RFisaac/PicoMondo/README.md

# PicoMondo

RP2350B control board for museum and maker exhibits (Clark Planetarium), designed in KiCad 10.

- `kicad/` is the project (`picomondo.kicad_pro`). Start with `kicad/README.md` and `kicad/DECISIONS.md`.
- `kicad/tools/` holds the Python scripts that generate and check the schematic and board.
