RFisaac/PicoMondo/kicad/bom/BOM_REPORT.md

# BOM report

Generated by `tools/bom.py` from `picomondo.kicad_pcb`. 240 parts with an LCSC number on 67 line items; 46 extended or preferred line items (JLCPCB charges a loading fee per extended part type; check their current fee schedule). Stock check assumes 5 boards and a 3x margin.

## Line items

| Refs | Qty | Value | LCSC | Type | Stock | Unit price | Note |
|---|---|---|---|---|---|---|---|
| C1,C2,C5... | 4 | 4.7u | C23733 | basic | 2365245 | 0.0167 |  |
| C3,C4,C7... | 20 | 100n | C307331 | basic | 15344796 | 0.0092 |  |
| C17,C18 | 2 | 15p | C106997 | extended | 2278248 | 0.0020 |  |
| C21,C22,C23... | 4 | 10u 50V | C7432782 | extended | 100526 | 0.2051 |  |
| C29,C30,C31... | 6 | 22u 16V | C2985039 | extended | 801 | 0.3191 |  |
| C37 | 1 | 10n | C15195 | basic | 4017940 | 0.0050 |  |
| C38 | 1 | 3.3n | C26404 | preferred | 232147 | 0.0068 |  |
| C16,C36,C40... | 7 | 10u 10V | C15850 | basic | 4904066 | 0.0657 |  |
| C46 | 1 | 4.7u 25V | C1779 | basic | 2968755 | 0.0348 |  |
| C47,C48 | 2 | 1u 10V | C52923 | basic | 8321740 | 0.0108 |  |
| C49 | 1 | 1u 25V | C5673 | extended | 4396637 | 0.0278 |  |
| D1,D2,D3 | 3 | SS54F-HF 5A 40V | C5142774 | extended | 5302 | 0.2241 |  |
| D4 | 1 | SMBJ28A | C178227 | extended | 26078 | 0.1079 |  |
| D6 | 1 | BZT52C12 12V | C177013 | extended | 6524 | 0.0570 |  |
| D5,D7 | 2 | SS54-HF | C22452 | basic | 2389672 | 0.0447 |  |
| D8 | 1 | red | C2286 | basic | 4789156 | 0.0076 |  |
| D9 | 1 | ESDA25P35-1U1M | C1974707 | extended | 1426 | 0.1904 |  |
| D10 | 1 | ESDA25W | C2935152 | extended | 1027 | 0.1444 |  |
| D11,D12,D13... | 32 | white | C7220928 | extended | 545 | 0.2657 |  |
| D41 | 1 | 1N5819HW | C82544 | extended | 138574 | 0.0570 |  |
| D42 | 1 | WS2812B-V5 | C2874885 | extended | 89621 | 0.1107 |  |
| F1 | 1 | 5A hold 30V | C19078763 | extended | 68759 | 0.1610 |  |
| F2,F3,F4 | 3 | 3A hold 33V | C54300298 | extended | 5652 | 0.2187 |  |
| J7,J8 | 2 | J8 V_INPUT out | C474881 | extended | 75284 | 0.1019 |  |
| J10 | 1 | SWD | C239521 | extended | 2288 | 0.2012 |  |
| J11 | 1 | Barrel 5.5x2.1 | C3096093 | extended | 1052 | 1.0956 |  |
| J12 | 1 | Terminal 2P | C2765055 | extended | 27443 |  |  |
| J13 | 1 | USB-C | C3020560 | extended | 591 | 1.3092 |  |
| J14,J16 | 2 | Arduino power | C124416 | extended | 2667 | 0.1777 |  |
| J15 | 1 | Arduino analog | C124415 | extended | 1403 | 0.1246 |  |
| J17 | 1 | Arduino digital 8-13 | C124423 | extended | 4711 | 0.1886 |  |
| J18,J19 | 2 | Pico right (pins 40-21) | C124410 | extended | 1093 | 0.3688 |  |
| L1 | 1 | 3.3u | C42411119 | extended | 1922 | 0.2858 |  |
| L2 | 1 | 4.7u | C19271849 | extended | 157 | 13.3080 |  |
| Q1,Q2 | 2 | CSD18543Q3A | C840100 | extended | 11977 | 0.8017 |  |
| Q4,Q6,Q8 | 3 | MMBT3904 | C81464 | extended | 1556997 | 0.0167 |  |
| Q5 | 1 | DMP4015SSS-13 | C508210 | extended | 2589 | 1.2977 |  |
| Q3,Q7 | 2 | SI2305A | C347488 | extended | 47845 | 0.0409 |  |
| R1 | 1 | 33 | C25105 | basic | 1815062 | 0.0012 |  |
| R10,R11 | 2 | 27 | C25100 | extended | 56281 | 0.0019 |  |
| R12 | 1 | 10m 1% 1W | C500718 | extended | 2320 | 0.0814 |  |
| R13 | 1 | 49.9k 1% | C25897 | preferred | 35168 | 0.0015 |  |
| R14 | 1 | 33.2k 1% | C122548 | extended | 349568 | 0.0007 |  |
| R3,R16 | 2 | 0 | C17168 | basic | 9185166 | 0.0025 |  |
| R17 | 1 | 7.5k | C25918 | preferred | 1196541 | 0.0022 |  |
| R18 | 1 | 220k 1% | C25767 | preferred | 158069 | 0.0023 |  |
| R19 | 1 | 88.7k 1% | C25922 | extended | 101022 | 0.0016 |  |
| R22,R28,R33 | 3 | 47k | C25792 | basic | 5520539 | 0.0026 |  |
| R15,R25,R31... | 6 | 100k | C25741 | basic | 8203089 | 0.0025 |  |
| R21,R27 | 2 | 20m 1% 2W | C500720 | extended | 3543 | 0.0800 |  |
| R29 | 1 | 22k | C31850 | basic | 3694042 | 0.0042 |  |
| R32 | 1 | 22k | C25768 | basic | 813018 | 0.0024 |  |
| R20,R23,R24... | 14 | 10k | C25744 | basic | 21560265 | 0.0034 |  |
| R2,R8,R9... | 5 | 1k | C11702 | basic | 7068307 | 0.0019 |  |
| R43,R111,R112 | 3 | 4.7k | C25900 | basic | 15447153 | 0.0027 |  |
| R44,R45,R46... | 29 | 100 | C25076 | basic | 4079878 | 0.0013 |  |
| R37,R72,R73... | 33 | 470 | C25117 | basic | 844142 | 0.0027 |  |
| SW1,SW2 | 2 | RESET | C318884 | basic | 467503 | 0.0207 |  |
| U1 | 1 | RP2350B | C42415655 | extended | 3393 | 1.2920 |  |
| U2 | 1 | W25Q128JVS | C97521 | basic | 48814 | 2.5782 |  |
| U4 | 1 | TPS55288 | C2864583 | extended | 5147 | 2.2214 |  |
| U5,U6 | 2 | AP2112K-3.3 | C51118 | extended | 37854 | 0.1726 |  |
| U7,U8 | 2 | INA226 (0x40) | C49851 | extended | 43725 | 0.7621 |  |
| U9 | 1 | USBLC6-2SC6 | C7519 | extended | 46944 | 0.1784 |  |
| U10 | 1 | STUSB4500 | C2678061 | extended | 4876 | 2.6826 |  |
| U11 | 1 | microSD | C428492 | extended | 23940 | 1.1476 |  |
| Y1 | 1 | ABM8-272-T3 | C20625731 | extended | 12836 | 0.6255 |  |

## Through-hole parts in the BOM (not in the SMD placement file)

D1, D2, D3, D5, D7, D10, D11, D12, D13, D14, D15, D16, D17, D18, D19, D20, D21, D22, D23, D24, D25, D26, D27, D28, D29, D30, D31, D32, D33, D34, D35, D36, D37, D38, D39, D40, D43, D44, F1, F2, F3, F4, J7, J8, J11, J14, J15, J16, J17, J18, J19

## Footprint-only items (no purchase)
