RFisaac/PicoMondo/kicad/picomondo.kicad_pcb

## KiCad design kicad/picomondo.kicad_pcb (2026-10-06)

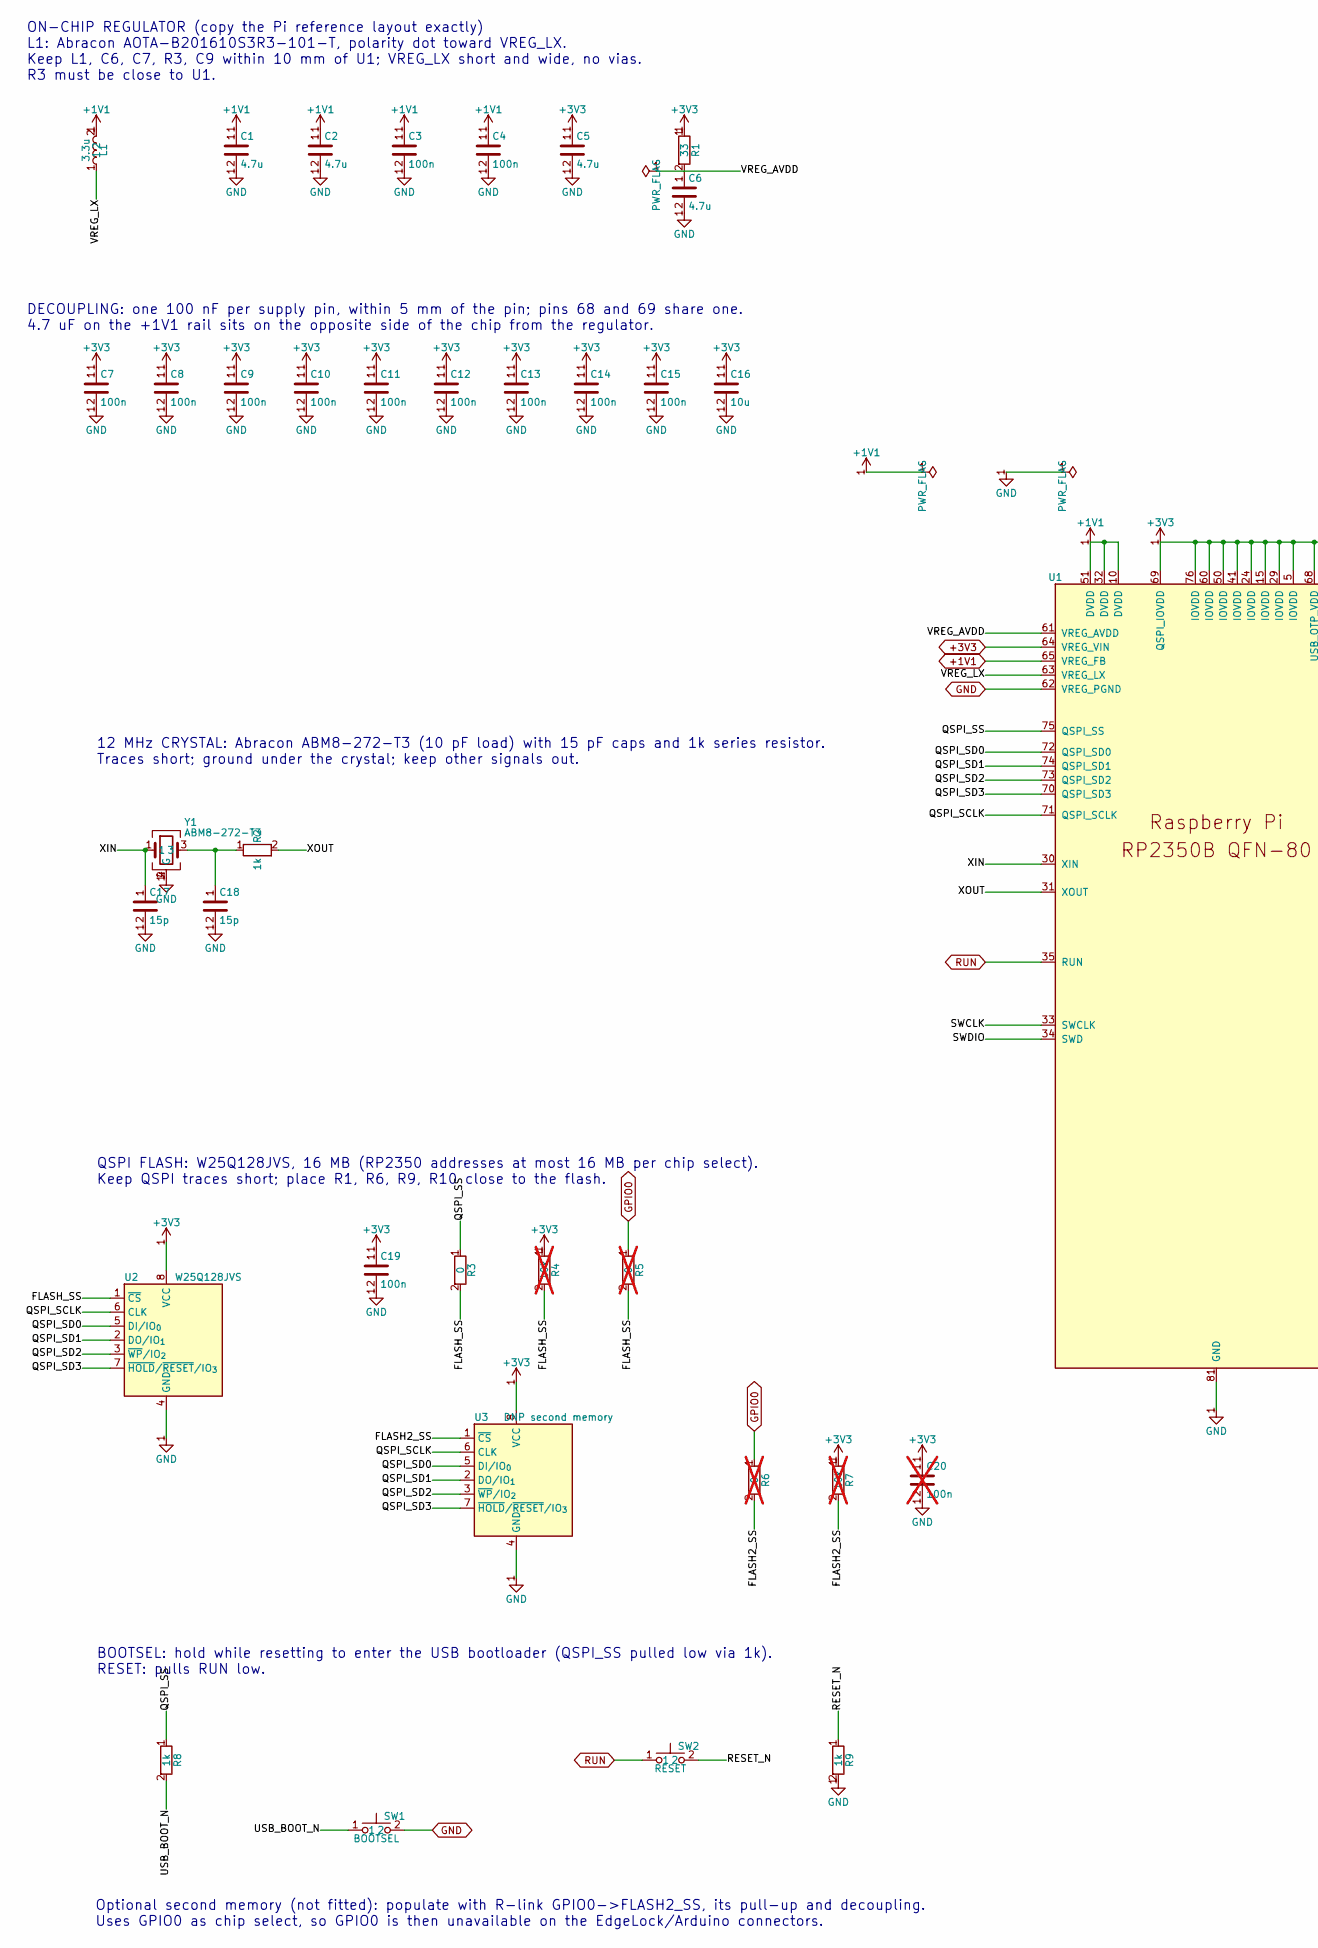
[picture p1: schematic mcu_core.kicad_sch, MCU core, part in row 1, column 1]

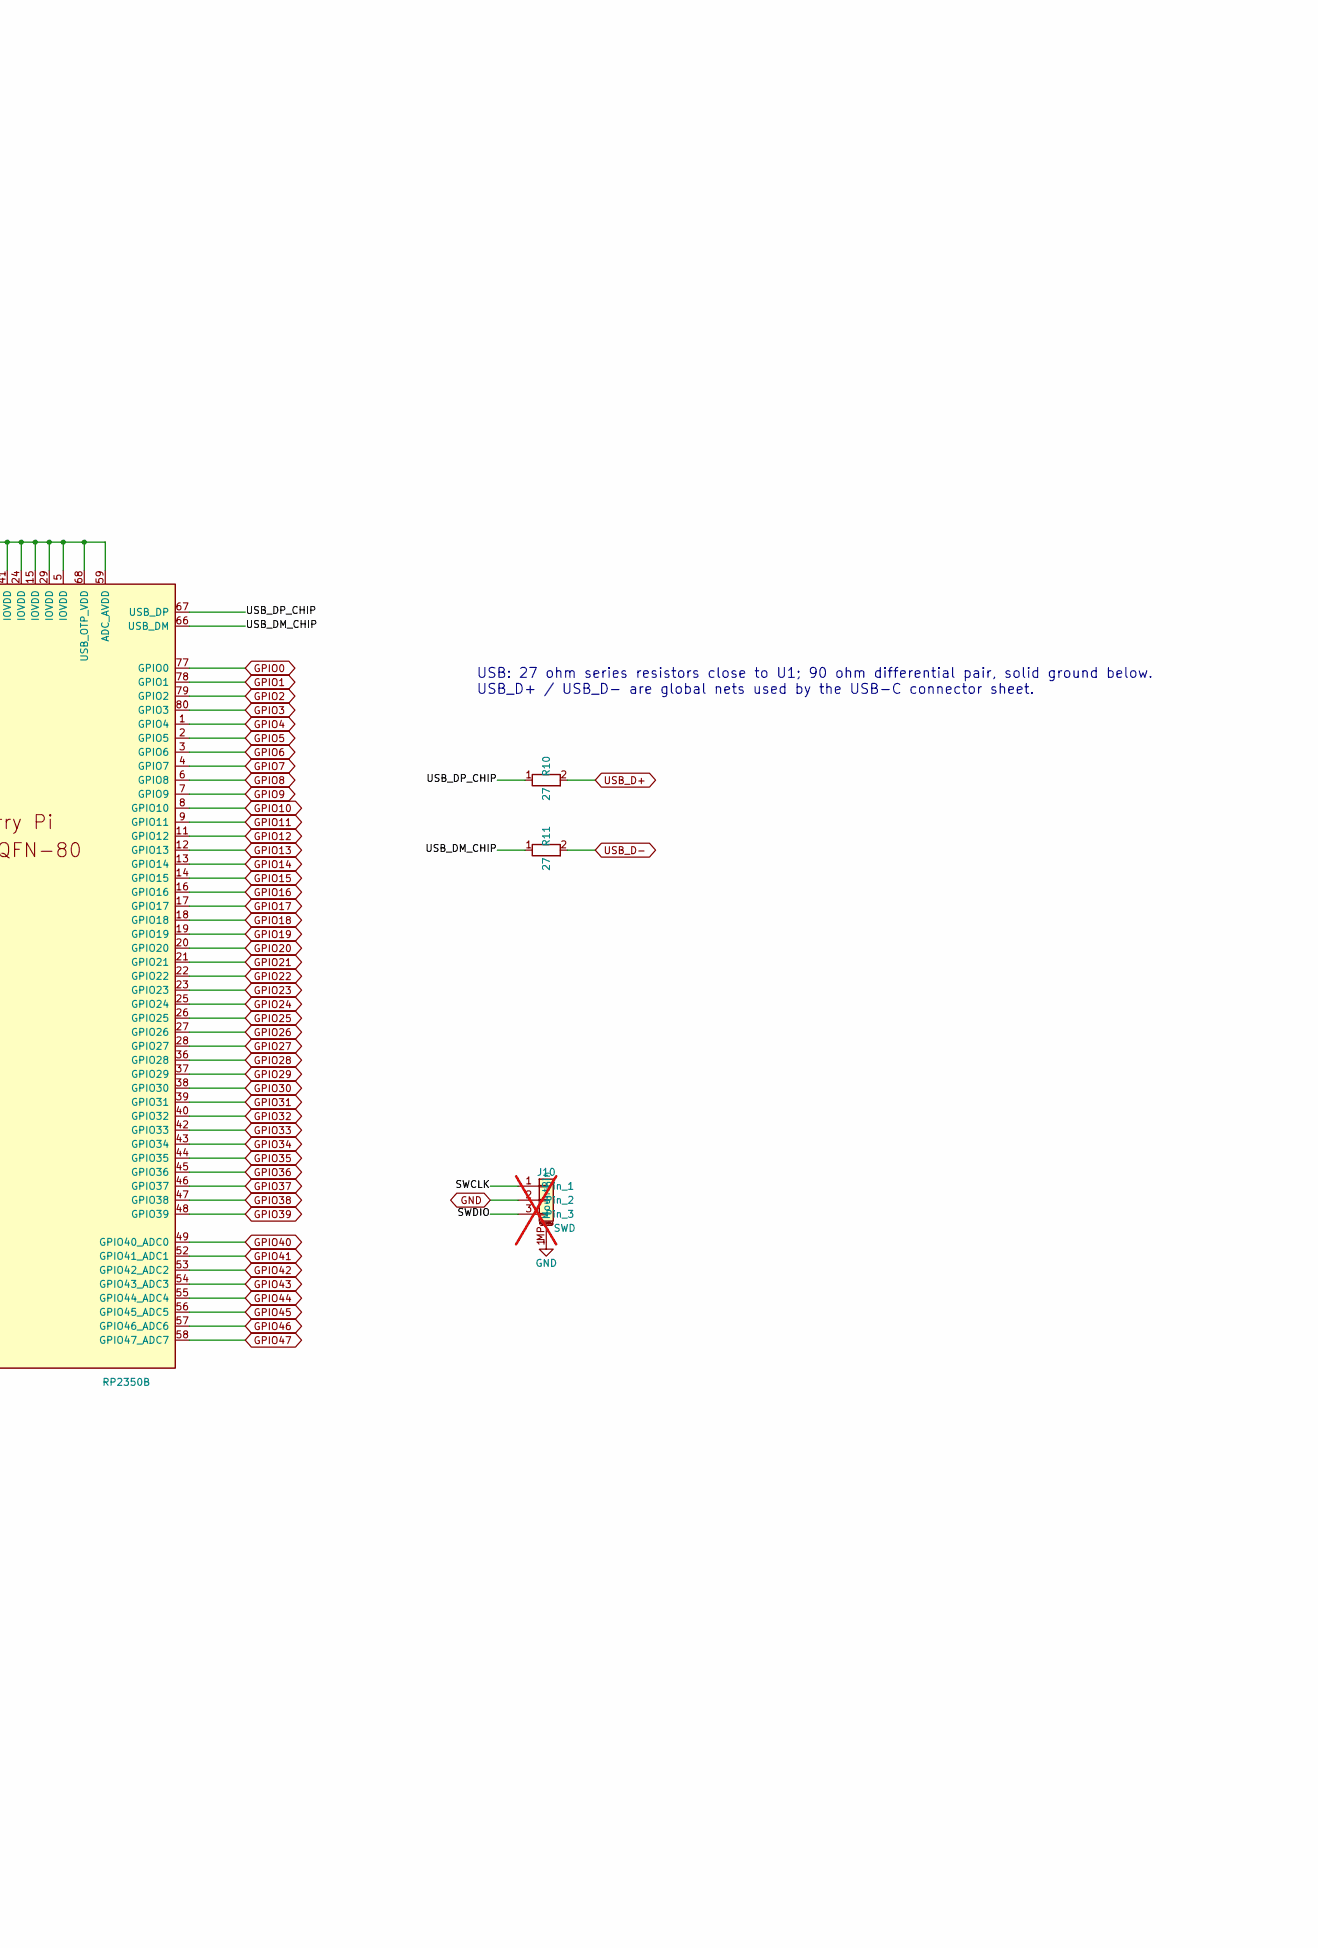
[picture p2: schematic mcu_core.kicad_sch, MCU core, part in row 1, column 2]

Parts:
C1, C2, C5, C6: 4.7u; C_0402_1005Metric_small_pads; MPN CL05A475MP5NRNC; LCSC C23733
C3, C4, C7, C8, C9, C10, C11, C12, C13, C14, C15, C19: 100n; C_0402_1005Metric; MPN CL05B104KB54PNC; LCSC C307331
C16: 10u; C_0805_2012Metric; MPN CL21A106KAYNNNE; LCSC C15850
C17, C18: 15p; C_0402_1005Metric; MPN CC0402JRNPO9BN150; LCSC C106997
C20: 100n; C_0402_1005Metric; MPN CL05B104KB54PNC; LCSC C307331; not fitted
J10: SWD; PinHeader_1x03_P2.54mm_Horizontal; LCSC C239521; not fitted
L1: 3.3u; L_pol_2016; MPN AOTA-B201610S3R3-101-T; LCSC C42411119
R1: 33; R_0402_1005Metric; MPN 0402WGF330JTCE; LCSC C25105
R2, R8, R9: 1k; R_0402_1005Metric; MPN 0402WGF1001TCE; LCSC C11702
R3: 0; R_0402_1005Metric; MPN 0402WGF0000TCE; LCSC C17168
R4, R7: 10k; R_0402_1005Metric; MPN 0402WGF1002TCE; LCSC C25744; not fitted
R5, R6: 0; R_0402_1005Metric; MPN 0402WGF0000TCE; LCSC C17168; not fitted
R10, R11: 27; R_0402_1005Metric; MPN 0402WGF270JTCE; LCSC C25100
SW1: BOOTSEL; SW_SMD_TS-1187A_5.1x5.1; MPN TS-1187A-B-A-B; LCSC C318884
SW2: RESET; SW_SMD_TS-1187A_5.1x5.1; MPN TS-1187A-B-A-B; LCSC C318884
U1: RP2350B; RP2350-QFN-80-1EP_10x10_P0.4mm_EP3.4x3.4mm_ThermalVias; MPN RP2350B; LCSC C42415655
U2: W25Q128JVS; SOIC-8_5.3x5.3mm_P1.27mm; MPN W25Q128JVSIQ; LCSC C97521
U3: DNP second memory; SOIC-8_5.3x5.3mm_P1.27mm
Y1: ABM8-272-T3; Crystal_SMD_3225-4Pin_3.2x2.5mm; MPN ABM8-272-T3; LCSC C20625731

Connections:
+1V1: C1.1, C2.1, C3.1, C4.1, L1.2, U1.10 (DVDD), U1.32 (DVDD), U1.51 (DVDD), U1.65 (VREG_FB); also elsewhere on the board
+3V3: C5.1, C7.1, C8.1, C9.1, C10.1, C11.1, C12.1, C13.1, C14.1, C15.1, C16.1, C19.1, C20.1, R1.1, R4.1, R7.1, U1.5 (IOVDD), U1.15 (IOVDD), U1.24 (IOVDD), U1.29 (IOVDD), U1.41 (IOVDD), U1.50 (IOVDD), U1.59 (ADC_AVDD), U1.60 (IOVDD), U1.64 (VREG_VIN), U1.68 (USB_OTP_VDD), U1.69 (QSPI_IOVDD), U1.76 (IOVDD), U2.8 (VCC), U3.8 (VCC); also elsewhere on the board
/MCU core/FLASH2_SS: R6.2, R7.2, U3.1 (~CS)
/MCU core/FLASH_SS: R3.2, R4.2, R5.2, U2.1 (~CS)
/MCU core/QSPI_SCLK: U1.71 (QSPI_SCLK), U2.6 (CLK), U3.6 (CLK)
/MCU core/QSPI_SD0: U1.72 (QSPI_SD0), U2.5 (DI/IO_{0}), U3.5 (DI/IO_{0})
/MCU core/QSPI_SD1: U1.74 (QSPI_SD1), U2.2 (DO/IO_{1}), U3.2 (DO/IO_{1})
/MCU core/QSPI_SD2: U1.73 (QSPI_SD2), U2.3 (~WP/IO_{2}), U3.3 (~WP/IO_{2})
/MCU core/QSPI_SD3: U1.70 (QSPI_SD3), U2.7 (~HOLD/~RESET/IO_{3}), U3.7 (~HOLD/~RESET/IO_{3})
/MCU core/QSPI_SS: R3.1, R8.1, U1.75 (QSPI_SS)
/MCU core/RESET_N: R9.1, SW2.2
/MCU core/SWCLK: J10.1, U1.33 (SWCLK)
/MCU core/SWDIO: J10.3, U1.34 (SWD)
/MCU core/USB_BOOT_N: R8.2, SW1.1
/MCU core/USB_DM_CHIP: R11.1, U1.66 (USB_DM)
/MCU core/USB_DP_CHIP: R10.1, U1.67 (USB_DP)
/MCU core/VREG_AVDD: C6.1, R1.2, U1.61 (VREG_AVDD)
/MCU core/VREG_LX: L1.1, U1.63 (VREG_LX)
/MCU core/XIN: C17.1, U1.30 (XIN), Y1.1
/MCU core/XOUT: R2.2, U1.31 (XOUT)
GND: C1.2, C2.2, C3.2, C4.2, C5.2, C6.2, C7.2, C8.2, C9.2, C10.2, C11.2, C12.2, C13.2, C14.2, C15.2, C16.2, C17.2, C18.2, C19.2, C20.2, J10.2, J10.MP (MountPin), R9.2, SW1.2, U1.62 (VREG_PGND), U1.81 (GND), U2.4 (GND), U3.4 (GND), Y1.2 (G), Y1.4 (G); also elsewhere on the board
GPIO0: R5.1, R6.1, U1.77 (GPIO0); also elsewhere on the board
GPIO1: U1.78 (GPIO1); also elsewhere on the board
GPIO2: U1.79 (GPIO2); also elsewhere on the board
GPIO3: U1.80 (GPIO3); also elsewhere on the board
GPIO4: U1.1 (GPIO4); also elsewhere on the board
GPIO5: U1.2 (GPIO5); also elsewhere on the board
GPIO6: U1.3 (GPIO6); also elsewhere on the board
GPIO7: U1.4 (GPIO7); also elsewhere on the board
GPIO8: U1.6 (GPIO8); also elsewhere on the board
GPIO9: U1.7 (GPIO9); also elsewhere on the board
GPIO10: U1.8 (GPIO10); also elsewhere on the board
GPIO11: U1.9 (GPIO11); also elsewhere on the board
GPIO12: U1.11 (GPIO12); also elsewhere on the board
GPIO13: U1.12 (GPIO13); also elsewhere on the board
GPIO14: U1.13 (GPIO14); also elsewhere on the board
GPIO15: U1.14 (GPIO15); also elsewhere on the board
GPIO16: U1.16 (GPIO16); also elsewhere on the board
GPIO17: U1.17 (GPIO17); also elsewhere on the board
GPIO18: U1.18 (GPIO18); also elsewhere on the board
GPIO19: U1.19 (GPIO19); also elsewhere on the board
GPIO20: U1.20 (GPIO20); also elsewhere on the board
GPIO21: U1.21 (GPIO21); also elsewhere on the board
GPIO22: U1.22 (GPIO22); also elsewhere on the board
GPIO23: U1.23 (GPIO23); also elsewhere on the board
GPIO24: U1.25 (GPIO24); also elsewhere on the board
GPIO25: U1.26 (GPIO25); also elsewhere on the board
GPIO26: U1.27 (GPIO26); also elsewhere on the board
GPIO27: U1.28 (GPIO27); also elsewhere on the board
GPIO28: U1.36 (GPIO28); also elsewhere on the board
GPIO29: U1.37 (GPIO29); also elsewhere on the board
GPIO30: U1.38 (GPIO30); also elsewhere on the board
GPIO31: U1.39 (GPIO31); also elsewhere on the board
GPIO32: U1.40 (GPIO32); also elsewhere on the board
GPIO33: U1.42 (GPIO33); also elsewhere on the board
GPIO34: U1.43 (GPIO34); also elsewhere on the board
GPIO35: U1.44 (GPIO35); also elsewhere on the board
GPIO36: U1.45 (GPIO36); also elsewhere on the board
GPIO37: U1.46 (GPIO37); also elsewhere on the board
GPIO38: U1.47 (GPIO38); also elsewhere on the board
GPIO39: U1.48 (GPIO39); also elsewhere on the board
GPIO40: U1.49 (GPIO40_ADC0); also elsewhere on the board
GPIO41: U1.52 (GPIO41_ADC1); also elsewhere on the board
GPIO42: U1.53 (GPIO42_ADC2); also elsewhere on the board
GPIO43: U1.54 (GPIO43_ADC3); also elsewhere on the board
GPIO44: U1.55 (GPIO44_ADC4); also elsewhere on the board
GPIO45: U1.56 (GPIO45_ADC5); also elsewhere on the board
GPIO46: U1.57 (GPIO46_ADC6); also elsewhere on the board
GPIO47: U1.58 (GPIO47_ADC7); also elsewhere on the board
unnamed: C18.1, R2.1, Y1.3
RUN: SW2.1, U1.35 (RUN); also elsewhere on the board
USB_D+: R10.2; also elsewhere on the board
USB_D-: R11.2; also elsewhere on the board

Notes on the sheet:
BOOTSEL: hold while resetting to enter the USB bootloader (QSPI_SS pulled low via 1k). RESET: pulls RUN low.
12 MHz CRYSTAL: Abracon ABM8-272-T3 (10 pF load) with 15 pF caps and 1k series resistor. Traces short; ground under the crystal; keep other signals out.
ON-CHIP REGULATOR (copy the Pi reference layout exactly) L1: Abracon AOTA-B201610S3R3-101-T, polarity dot toward VREG_LX. Keep L1, C6, C7, R3, C9 within 10 mm of U1; VREG_LX short and wide, no vias. R3 must be close to U1.
Optional second memory (not fitted): populate with R-link GPIO0->FLASH2_SS, its pull-up and decoupling. Uses GPIO0 as chip select, so GPIO0 is then unavailable on the EdgeLock/Arduino connectors.
QSPI FLASH: W25Q128JVS, 16 MB (RP2350 addresses at most 16 MB per chip select). Keep QSPI traces short; place R1, R6, R9, R10 close to the flash.
DECOUPLING: one 100 nF per supply pin, within 5 mm of the pin; pins 68 and 69 share one. 4.7 uF on the +1V1 rail sits on the opposite side of the chip from the regulator.
USB: 27 ohm series resistors close to U1; 90 ohm differential pair, solid ground below. USB_D+ / USB_D- are global nets used by the USB-C connector sheet.

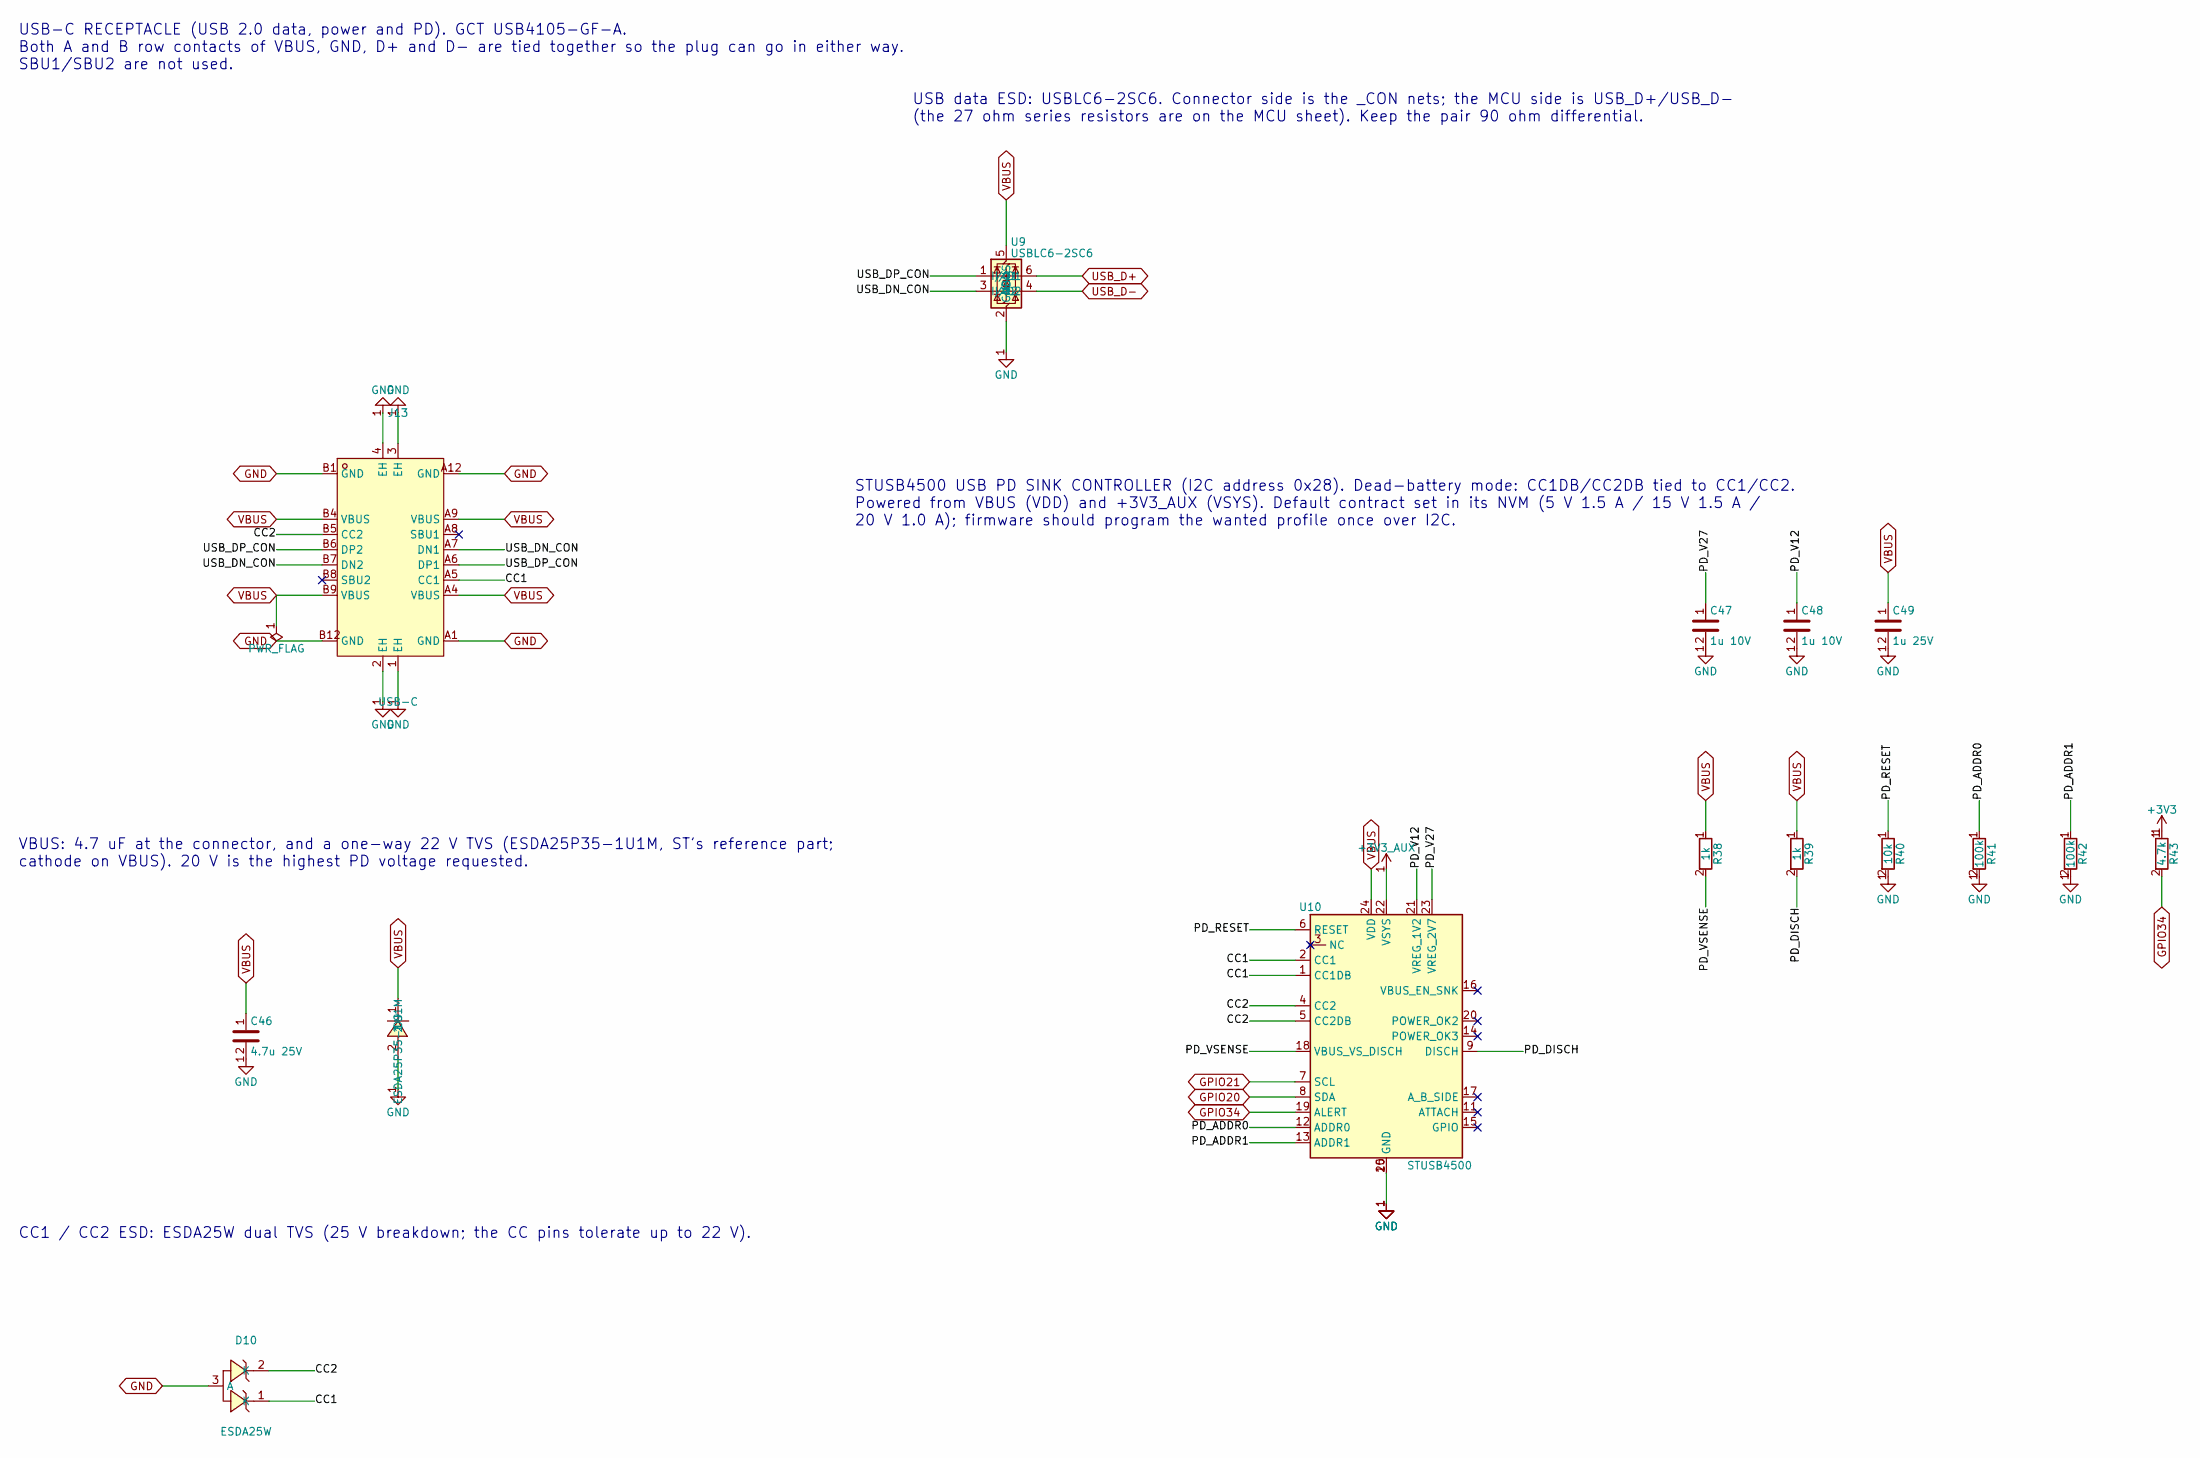
[picture p3: schematic usb_pd.kicad_sch, USB-C PD]

Parts:
C46: 4.7u 25V; C_0805_2012Metric; MPN CL21A475KAQNNNE; LCSC C1779
C47, C48: 1u 10V; C_0402_1005Metric; MPN CL05A105KA5NQNC; LCSC C52923
C49: 1u 25V; C_0603_1608Metric; MPN CL10A105KA8NNNC; LCSC C5673
D9: ESDA25P35-1U1M; DFN1610-2_L1.6-W1.0-P1.05-RD; MPN ESDA25P35-1U1M; LCSC C1974707
D10: ESDA25W; SOT-323-3_L2.1-W1.3-P1.32-LS2.1-BR; MPN ESDA25W; LCSC C2935152
J13: USB-C; TYPE-C-SMD_SBC-160S1A-20-S412; MPN USB4105-GF-A; LCSC C3020560
R38, R39: 1k; R_0402_1005Metric; MPN 0402WGF1001TCE; LCSC C11702
R40: 10k; R_0402_1005Metric; MPN 0402WGF1002TCE; LCSC C25744
R41, R42: 100k; R_0402_1005Metric; MPN 0402WGF1003TCE; LCSC C25741
R43: 4.7k; R_0402_1005Metric; MPN 0402WGF4701TCE; LCSC C25900
U9: USBLC6-2SC6; SOT-23-6; MPN USBLC6-2SC6; LCSC C7519
U10: STUSB4500; QFN-24-1EP_4x4mm_P0.5mm_EP2.7x2.7mm; MPN STUSB4500QTR; LCSC C2678061

Connections:
+3V3: R43.1; also elsewhere on the board
+3V3_AUX: U10.22 (VSYS); also elsewhere on the board
/USB-C PD/CC1: D10.1 (K), J13.A5 (CC1), U10.1 (CC1DB), U10.2 (CC1)
/USB-C PD/CC2: D10.2 (K), J13.B5 (CC2), U10.4 (CC2), U10.5 (CC2DB)
/USB-C PD/PD_ADDR0: R41.1, U10.12 (ADDR0)
/USB-C PD/PD_ADDR1: R42.1, U10.13 (ADDR1)
/USB-C PD/PD_DISCH: R39.2, U10.9 (DISCH)
/USB-C PD/PD_RESET: R40.1, U10.6 (RESET)
/USB-C PD/PD_V12: C48.1, U10.21 (VREG_1V2)
/USB-C PD/PD_V27: C47.1, U10.23 (VREG_2V7)
/USB-C PD/PD_VSENSE: R38.2, U10.18 (VBUS_VS_DISCH)
/USB-C PD/USB_DN_CON: J13.A7 (DN1), J13.B7 (DN2), U9.3 (I/O2)
/USB-C PD/USB_DP_CON: J13.A6 (DP1), J13.B6 (DP2), U9.1 (I/O1)
GND: C46.2, C47.2, C48.2, C49.2, D9.2, D10.3 (A), J13.1 (EH), J13.2 (EH), J13.3 (EH), J13.4 (EH), J13.A1 (GND), J13.A12 (GND), J13.B1 (GND), J13.B12 (GND), R40.2, R41.2, R42.2, U9.2 (GND), U10.10 (GND), U10.25 (GND); also elsewhere on the board
GPIO20: U10.8 (SDA); also elsewhere on the board
GPIO21: U10.7 (SCL); also elsewhere on the board
GPIO34: R43.2, U10.19 (ALERT); also elsewhere on the board
USB_D+: U9.6 (I/O1); also elsewhere on the board
USB_D-: U9.4 (I/O2); also elsewhere on the board
VBUS: C46.1, C49.1, D9.1, J13.A4 (VBUS), J13.A9 (VBUS), J13.B4 (VBUS), J13.B9 (VBUS), R38.1, R39.1, U9.5 (VBUS), U10.24 (VDD); also elsewhere on the board

Notes on the sheet:
VBUS: 4.7 uF at the connector, and a one-way 22 V TVS (ESDA25P35-1U1M, ST's reference part; cathode on VBUS). 20 V is the highest PD voltage requested.
USB data ESD: USBLC6-2SC6. Connector side is the _CON nets; the MCU side is USB_D+/USB_D- (the 27 ohm series resistors are on the MCU sheet). Keep the pair 90 ohm differential.
CC1 / CC2 ESD: ESDA25W dual TVS (25 V breakdown; the CC pins tolerate up to 22 V).
USB-C RECEPTACLE (USB 2.0 data, power and PD). GCT USB4105-GF-A. Both A and B row contacts of VBUS, GND, D+ and D- are tied together so the plug can go in either way. SBU1/SBU2 are not used.
STUSB4500 USB PD SINK CONTROLLER (I2C address 0x28). Dead-battery mode: CC1DB/CC2DB tied to CC1/CC2. Powered from VBUS (VDD) and +3V3_AUX (VSYS). Default contract set in its NVM (5 V 1.5 A / 15 V 1.5 A / 20 V 1.0 A); firmware should program the wanted profile once over I2C.

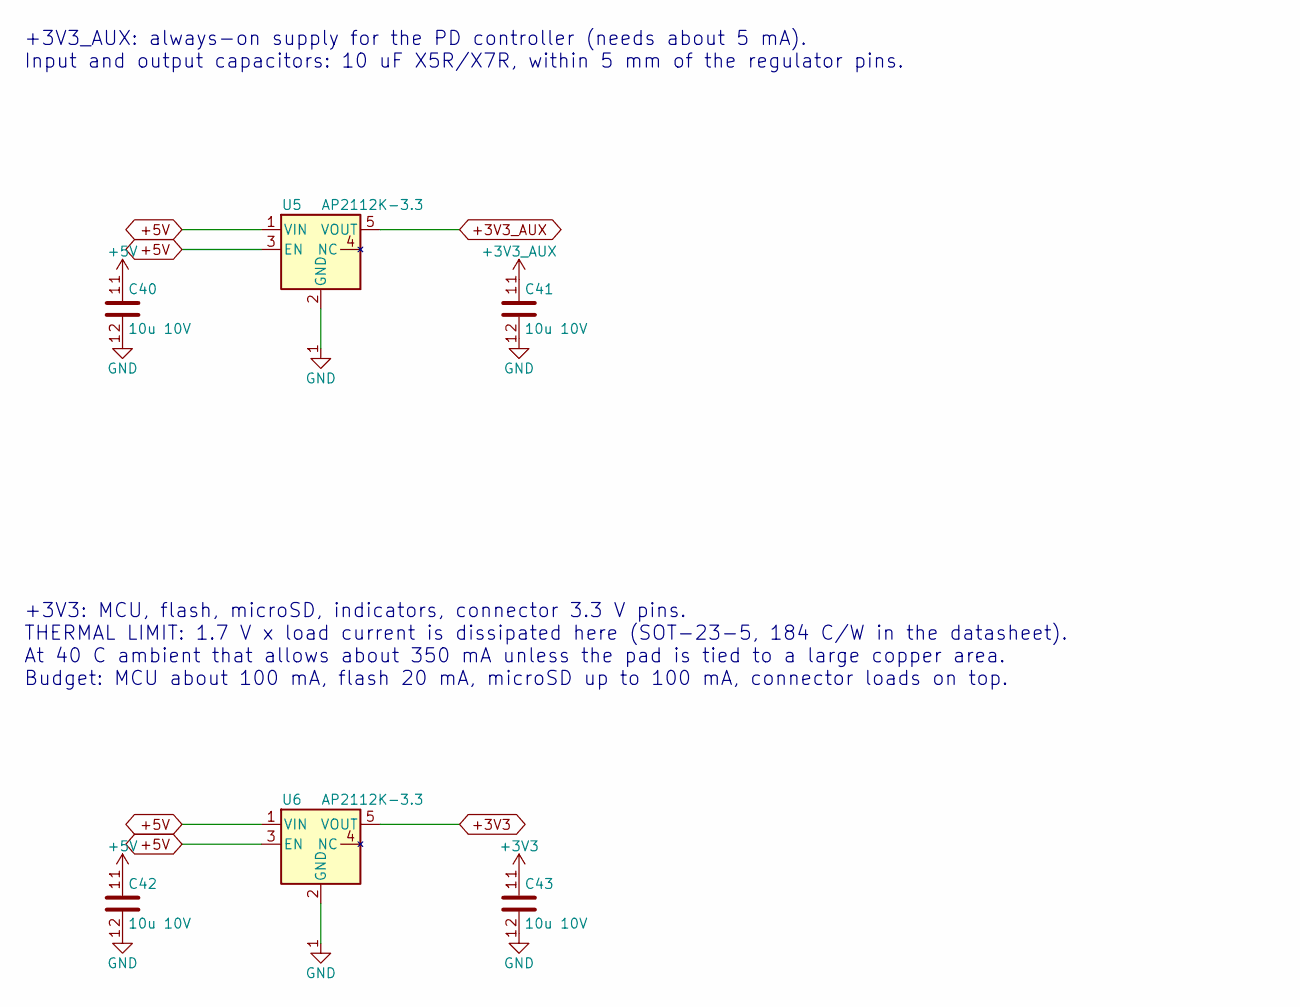
[picture p4: schematic power_ldo.kicad_sch, 3V3 regulators]

Parts:
C40, C41, C42, C43: 10u 10V; C_0805_2012Metric; MPN CL21A106KAYNNNE; LCSC C15850
U5, U6: AP2112K-3.3; SOT-23-5; MPN AP2112K-3.3TRG1; LCSC C51118

Connections:
+3V3: C43.1, U6.5 (VOUT); also elsewhere on the board
+3V3_AUX: C41.1, U5.5 (VOUT); also elsewhere on the board
+5V: C40.1, C42.1, U5.1 (VIN), U5.3 (EN), U6.1 (VIN), U6.3 (EN); also elsewhere on the board
GND: C40.2, C41.2, C42.2, C43.2, U5.2 (GND), U6.2 (GND); also elsewhere on the board

Notes on the sheet:
+3V3_AUX: always-on supply for the PD controller (needs about 5 mA). Input and output capacitors: 10 uF X5R/X7R, within 5 mm of the regulator pins.
+3V3: MCU, flash, microSD, indicators, connector 3.3 V pins. THERMAL LIMIT: 1.7 V x load current is dissipated here (SOT-23-5, 184 C/W in the datasheet). At 40 C ambient that allows about 350 mA unless the pad is tied to a large copper area. Budget: MCU about 100 mA, flash 20 mA, microSD up to 100 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

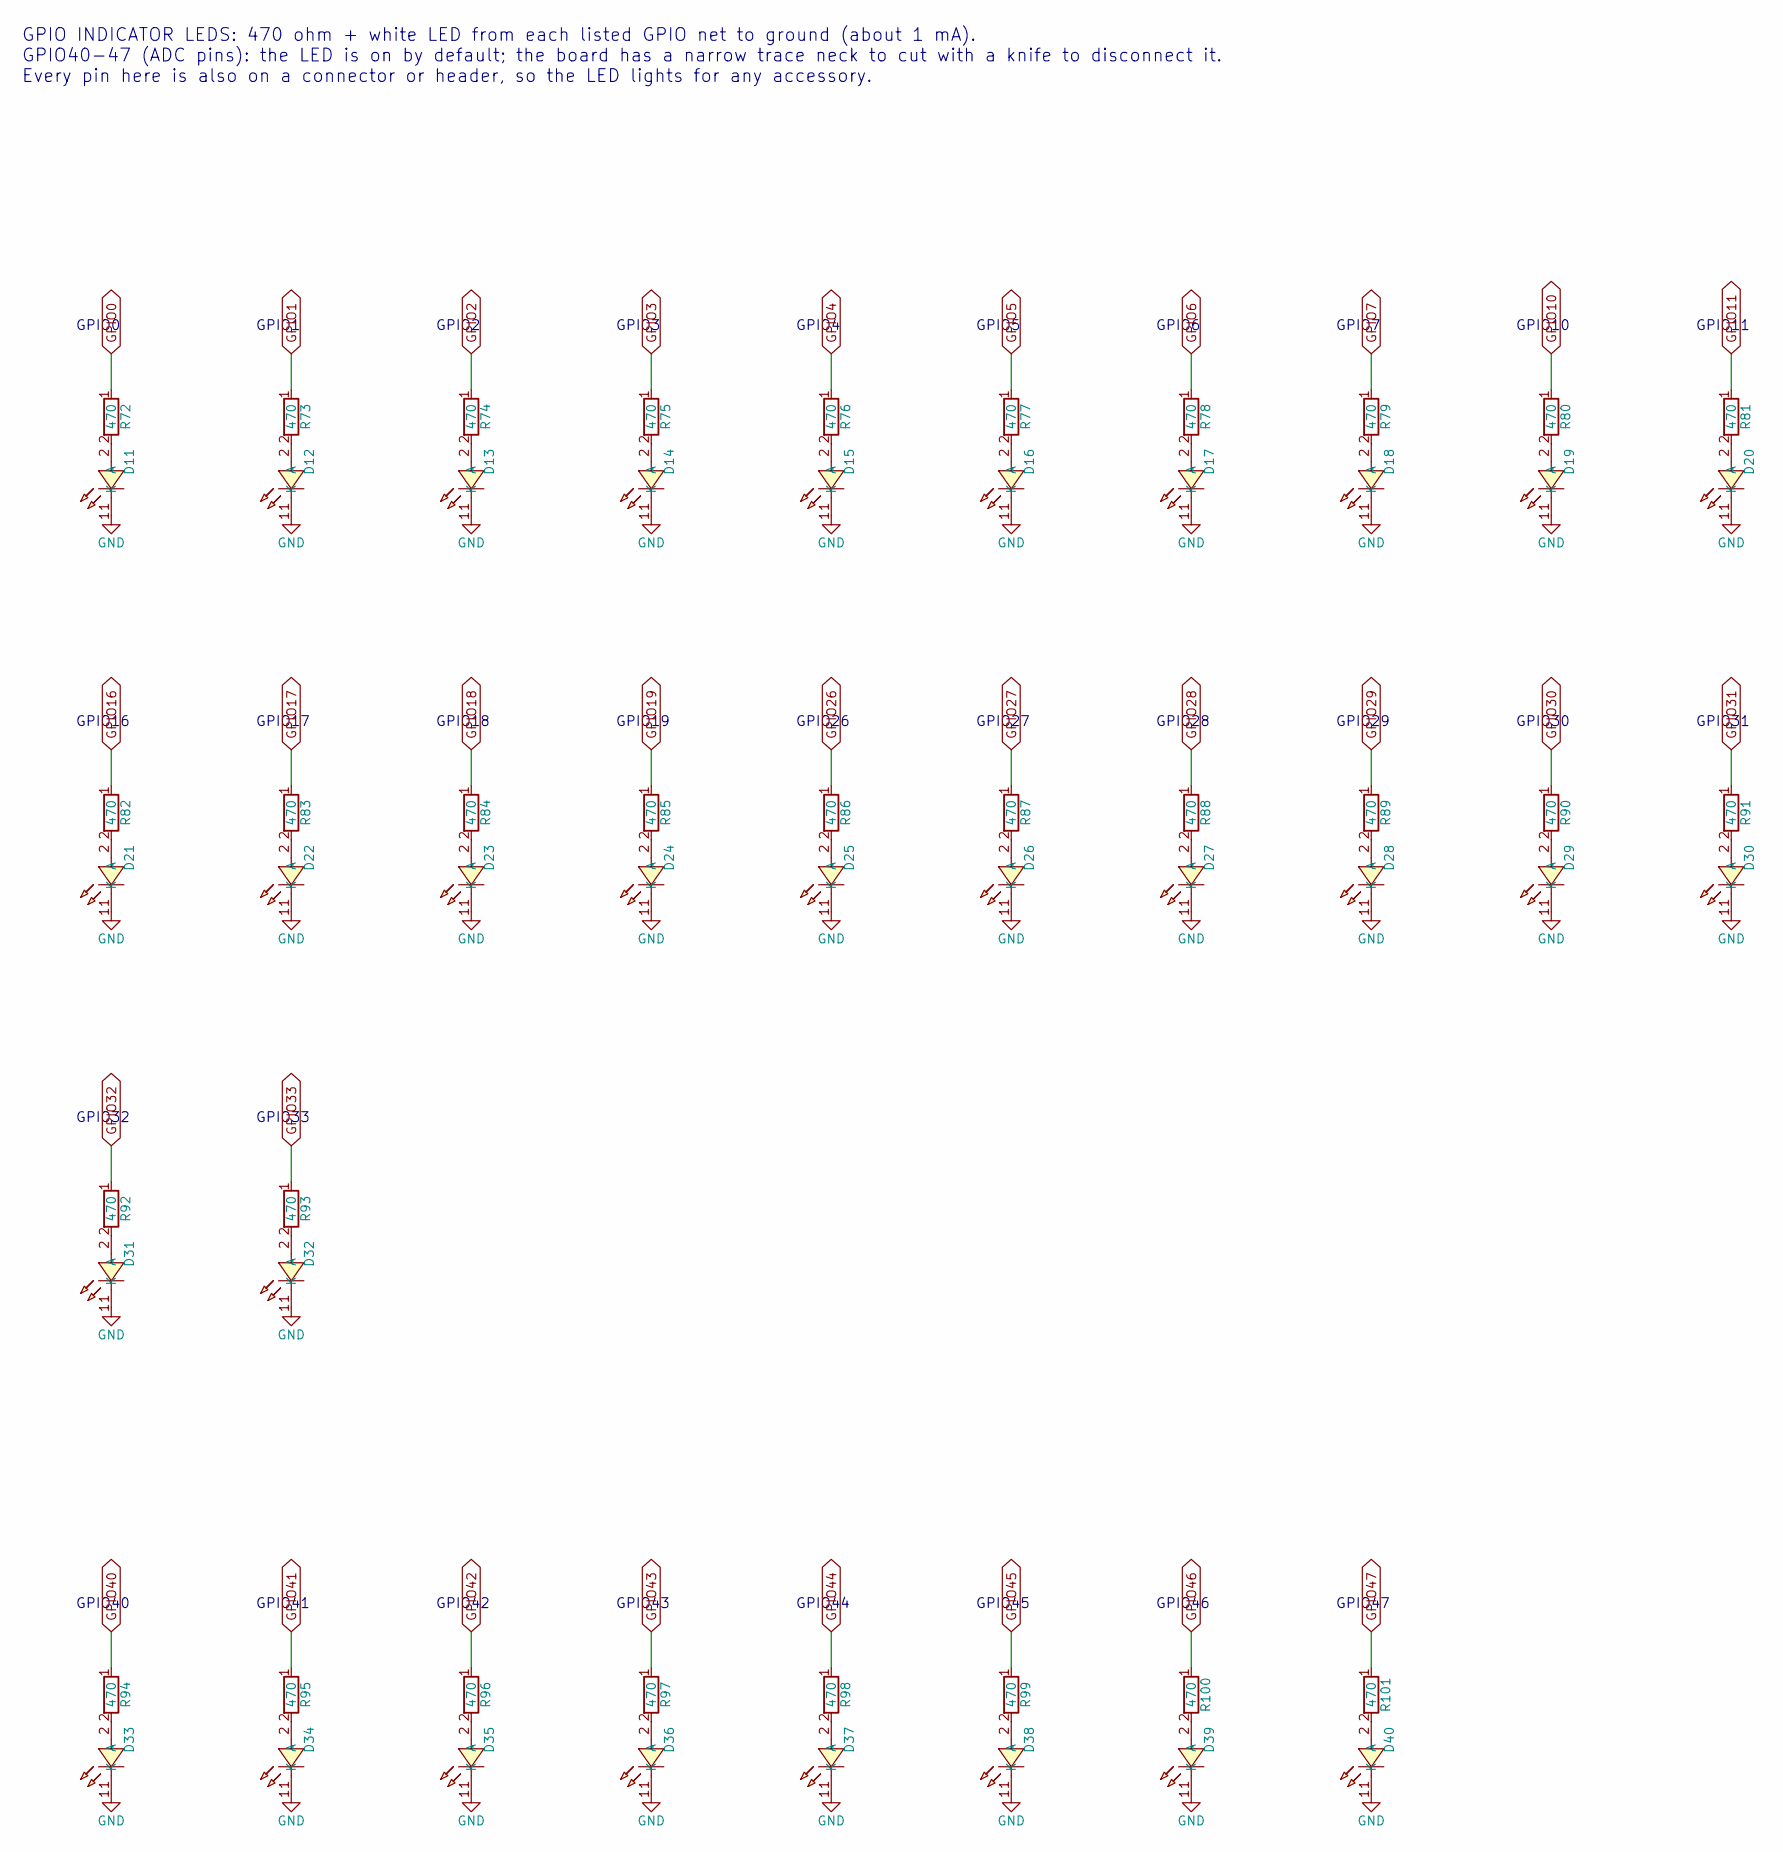
[picture p5: schematic io_indicators.kicad_sch, GPIO indicators]

Parts:
D11, D12, D13, D14, D15, D16, D17, D18, D19, D20, D21, D22, D23, D24, D25, D26, D27, D28, D29, D30, D31, D32, D33, D34, D35, D36, D37, D38, D39, D40: white; LED-SMD_L1.0-W0.5-RD_WHITE; MPN LW QH8G-Q2OO-3K5L-1; LCSC C7220928
R72, R73, R74, R75, R76, R77, R78, R79, R80, R81, R82, R83, R84, R85, R86, R87, R88, R89, R90, R91, R92, R93, R94, R95, R96, R97, R98, R99, R100, R101: 470; R_0402_1005Metric; MPN 0402WGF4700TCE; LCSC C25117

Connections:
GND: D11.1 (K), D12.1 (K), D13.1 (K), D14.1 (K), D15.1 (K), D16.1 (K), D17.1 (K), D18.1 (K), D19.1 (K), D20.1 (K), D21.1 (K), D22.1 (K), D23.1 (K), D24.1 (K), D25.1 (K), D26.1 (K), D27.1 (K), D28.1 (K), D29.1 (K), D30.1 (K), D31.1 (K), D32.1 (K), D33.1 (K), D34.1 (K), D35.1 (K), D36.1 (K), D37.1 (K), D38.1 (K), D39.1 (K), D40.1 (K); also elsewhere on the board
GPIO0: R72.1; also elsewhere on the board
GPIO1: R73.1; also elsewhere on the board
GPIO2: R74.1; also elsewhere on the board
GPIO3: R75.1; also elsewhere on the board
GPIO4: R76.1; also elsewhere on the board
GPIO5: R77.1; also elsewhere on the board
GPIO6: R78.1; also elsewhere on the board
GPIO7: R79.1; also elsewhere on the board
GPIO10: R80.1; also elsewhere on the board
GPIO11: R81.1; also elsewhere on the board
GPIO16: R82.1; also elsewhere on the board
GPIO17: R83.1; also elsewhere on the board
GPIO18: R84.1; also elsewhere on the board
GPIO19: R85.1; also elsewhere on the board
GPIO26: R86.1; also elsewhere on the board
GPIO27: R87.1; also elsewhere on the board
GPIO28: R88.1; also elsewhere on the board
GPIO29: R89.1; also elsewhere on the board
GPIO30: R90.1; also elsewhere on the board
GPIO31: R91.1; also elsewhere on the board
GPIO32: R92.1; also elsewhere on the board
GPIO33: R93.1; also elsewhere on the board
GPIO40: R94.1; also elsewhere on the board
GPIO41: R95.1; also elsewhere on the board
GPIO42: R96.1; also elsewhere on the board
GPIO43: R97.1; also elsewhere on the board
GPIO44: R98.1; also elsewhere on the board
GPIO45: R99.1; also elsewhere on the board
GPIO46: R100.1; also elsewhere on the board
GPIO47: R101.1; also elsewhere on the board
unnamed: D11.2 (A), R72.2
unnamed: D12.2 (A), R73.2
unnamed: D13.2 (A), R74.2
unnamed: D14.2 (A), R75.2
unnamed: D15.2 (A), R76.2
unnamed: D16.2 (A), R77.2
unnamed: D17.2 (A), R78.2
unnamed: D18.2 (A), R79.2
unnamed: D19.2 (A), R80.2
unnamed: D20.2 (A), R81.2
unnamed: D21.2 (A), R82.2
unnamed: D22.2 (A), R83.2
unnamed: D23.2 (A), R84.2
unnamed: D24.2 (A), R85.2
unnamed: D25.2 (A), R86.2
unnamed: D26.2 (A), R87.2
unnamed: D27.2 (A), R88.2
unnamed: D28.2 (A), R89.2
unnamed: D29.2 (A), R90.2
unnamed: D30.2 (A), R91.2
unnamed: D31.2 (A), R92.2
unnamed: D32.2 (A), R93.2
unnamed: D33.2 (A), R94.2
unnamed: D34.2 (A), R95.2
unnamed: D35.2 (A), R96.2
unnamed: D36.2 (A), R97.2
unnamed: D37.2 (A), R98.2
unnamed: D38.2 (A), R99.2
unnamed: D39.2 (A), R100.2
unnamed: D40.2 (A), R101.2

Notes on the sheet:
GPIO41
GPIO33
GPIO18
GPIO11
GPIO16
GPIO7
GPIO19
GPIO44
GPIO3
GPIO5
GPIO43
GPIO2
GPIO10
GPIO29
GPIO47
GPIO1
GPIO46
GPIO40
GPIO32
GPIO0
GPIO45
GPIO INDICATOR LEDS: 470 ohm + white LED from each listed GPIO net to ground (about 1 mA). GPIO40-47 (ADC pins): the LED is on by default; the board has a narrow trace neck to cut with a knife to disconnect it. Every pin here is also on a connector or header, so the LED lights for any accessory.
GPIO28
GPIO4
GPIO42
GPIO26
GPIO17
GPIO30
GPIO31
GPIO27
GPIO6
