RFisaac/PicoMondo/kicad/picomondo.kicad_pcb

## KiCad design kicad/picomondo.kicad_pcb (continued)

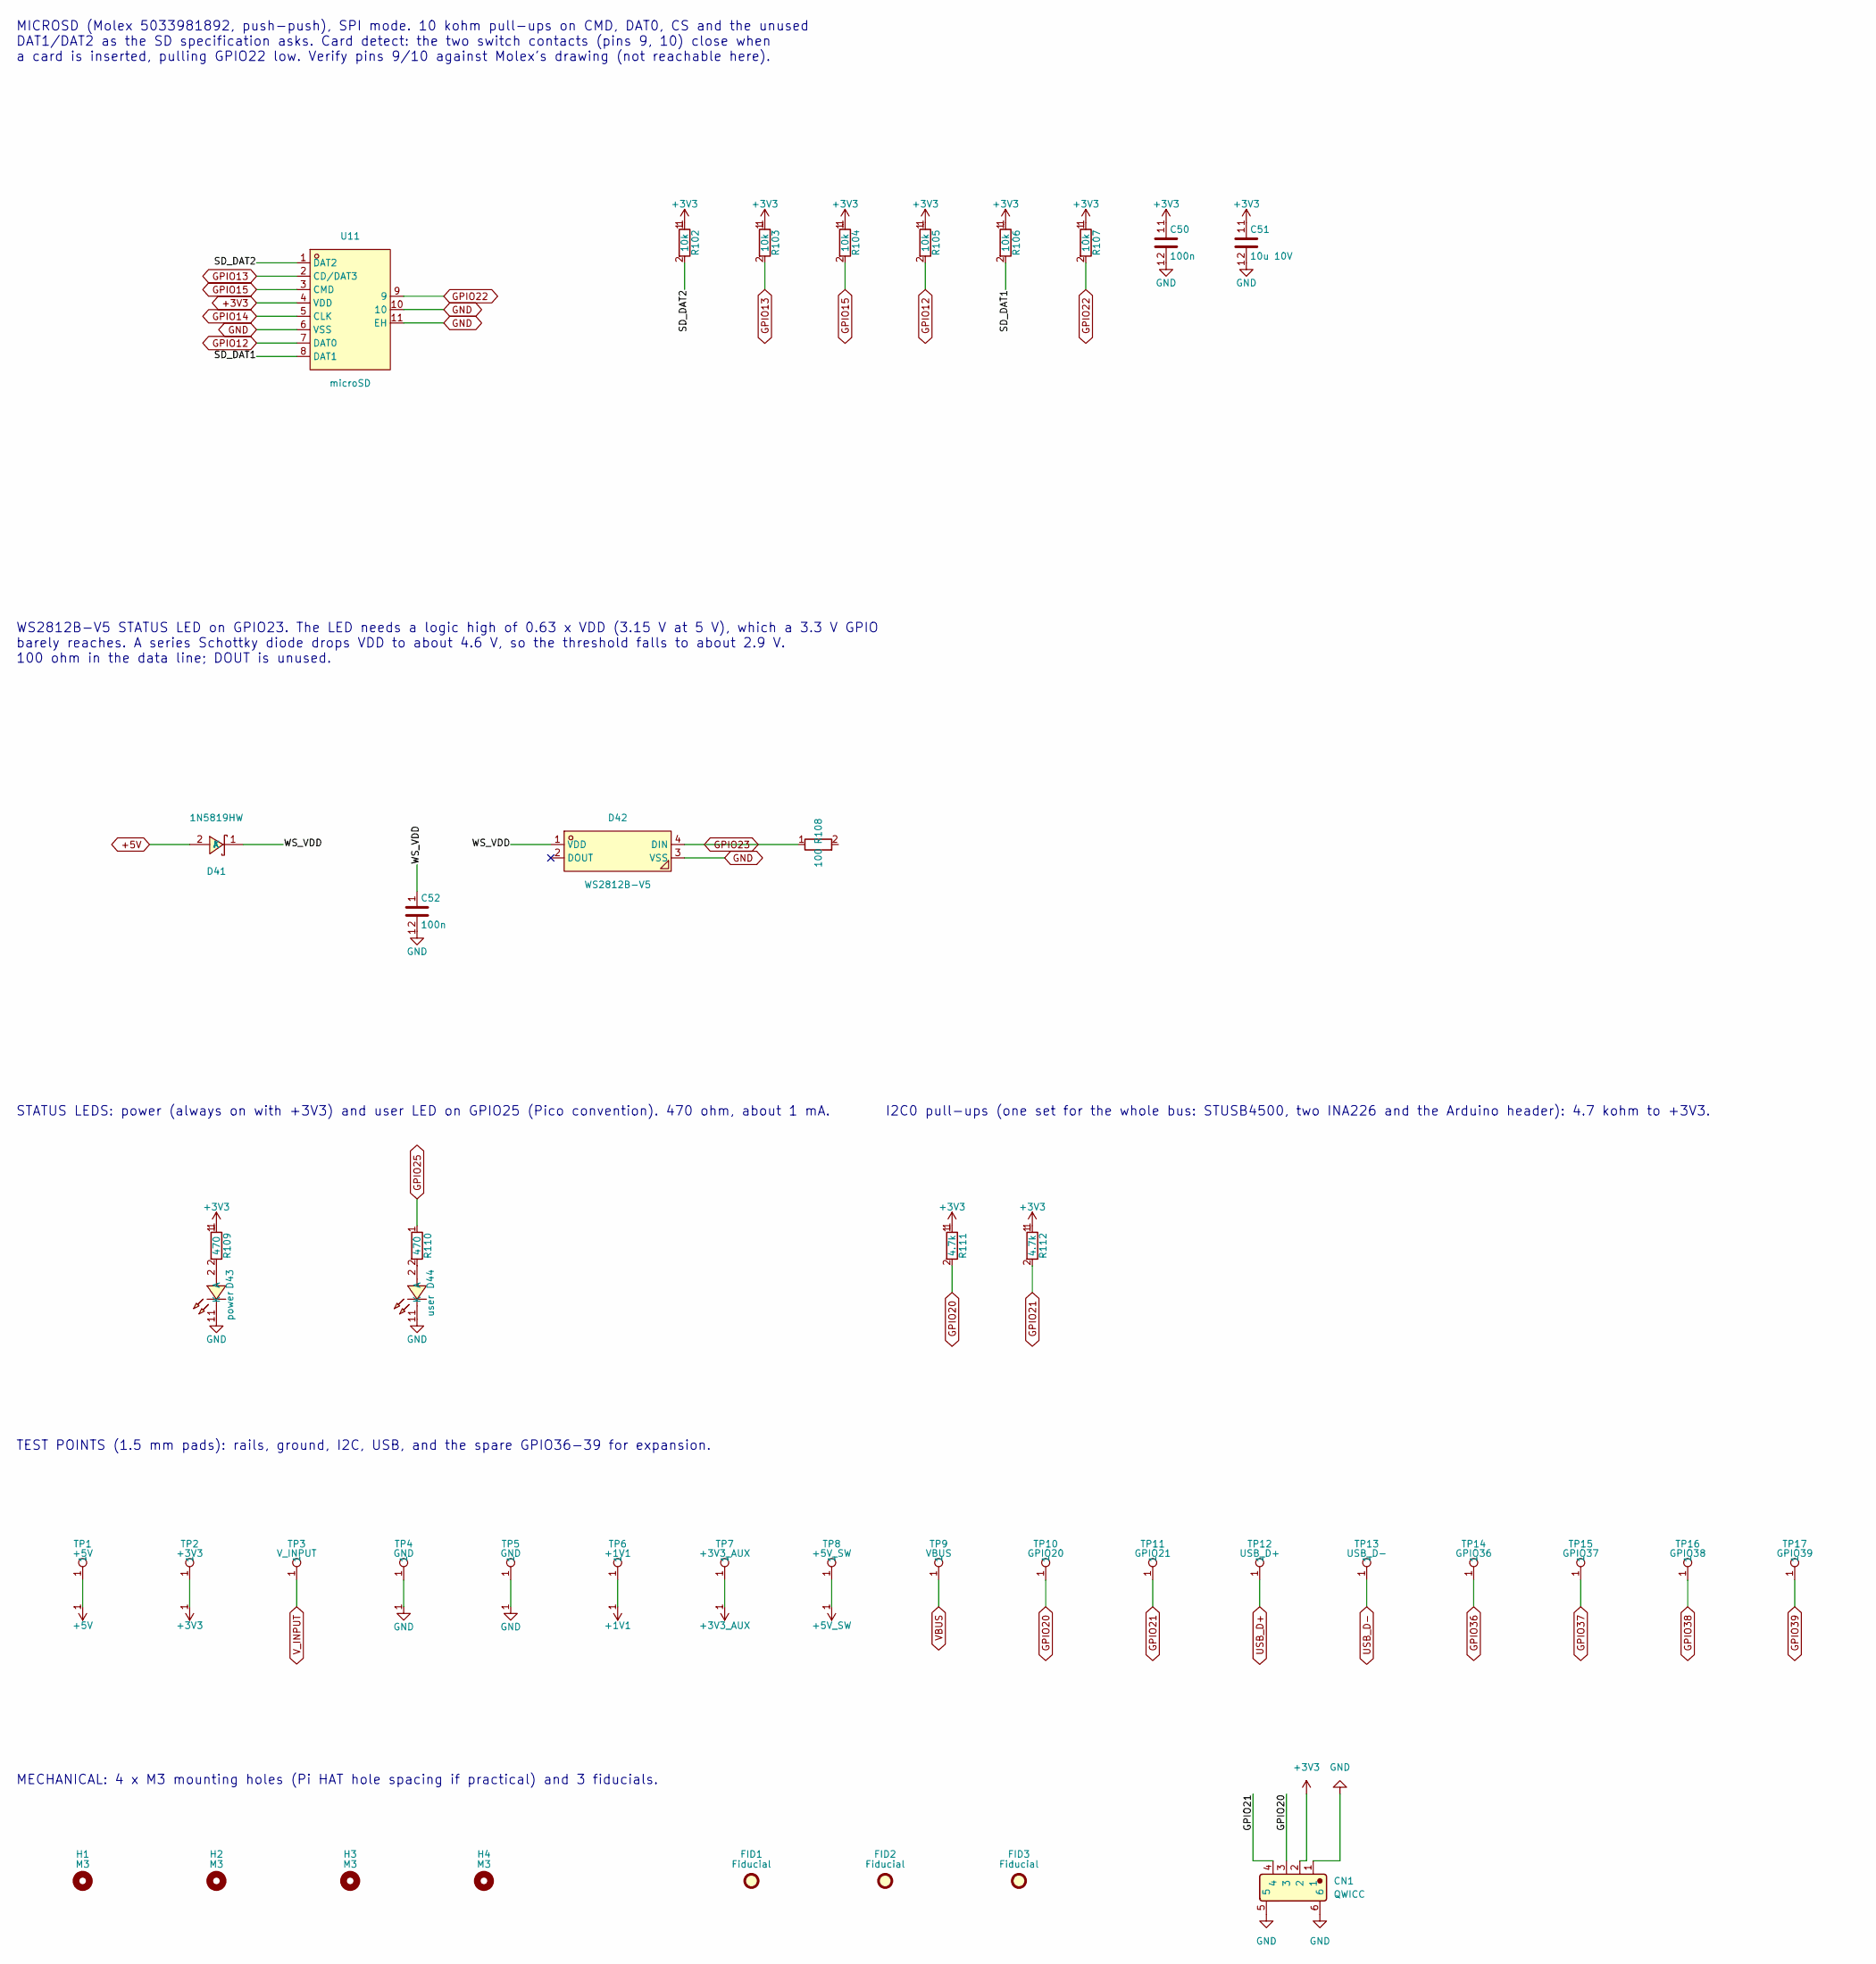
[picture p6: schematic io_misc.kicad_sch, Board support]

Parts:
C50, C52: 100n; C_0402_1005Metric; MPN CL05B104KB54PNC; LCSC C307331
C51: 10u 10V; C_0805_2012Metric; MPN CL21A106KAYNNNE; LCSC C15850
CN1: QWICC; XY-SM04B-SRSS-TB; Manufacturer Part XY-SM04B-SRSS-TB; LCSC C51940130
D41: 1N5819HW; SOD-123_L2.7-W1.6-LS3.7-RD; MPN 1N5819HW-7-F; LCSC C82544
D42: WS2812B-V5; LED-SMD_4P-L5.0-W5.0-LS5.4-TL-1; MPN WS2812B-V5/W; LCSC C2874885
D43: power; LED-SMD_L1.0-W0.5-RD_WHITE; MPN LW QH8G-Q2OO-3K5L-1; LCSC C7220928
D44: user; LED-SMD_L1.0-W0.5-RD_WHITE; MPN LW QH8G-Q2OO-3K5L-1; LCSC C7220928
FID1, FID2, FID3: Fiducial; Fiducial_1mm_Mask2mm
H1, H2, H3, H4: M3; MountingHole_3.2mm_M3
R102, R103, R104, R105, R106, R107: 10k; R_0402_1005Metric; MPN 0402WGF1002TCE; LCSC C25744
R108: 100; R_0402_1005Metric; MPN 0402WGF1000TCE; LCSC C25076
R109, R110: 470; R_0402_1005Metric; MPN 0402WGF4700TCE; LCSC C25117
R111, R112: 4.7k; R_0402_1005Metric; MPN 0402WGF4701TCE; LCSC C25900
TP1: +5V; TestPoint_Pad_D1.5mm
TP2: +3V3; TestPoint_Pad_D1.5mm
TP3: V_INPUT; TestPoint_Pad_D1.5mm
TP4, TP5: GND; TestPoint_Pad_D1.5mm
TP6: +1V1; TestPoint_Pad_D1.5mm
TP7: +3V3_AUX; TestPoint_Pad_D1.5mm
TP8: +5V_SW; TestPoint_Pad_D1.5mm
TP9: VBUS; TestPoint_Pad_D1.5mm
TP10: GPIO20; TestPoint_Pad_D1.5mm
TP11: GPIO21; TestPoint_Pad_D1.5mm
TP12: USB_D+; TestPoint_Pad_D1.5mm
TP13: USB_D-; TestPoint_Pad_D1.5mm
TP14: GPIO36; TestPoint_Pad_D1.5mm
TP15: GPIO37; TestPoint_Pad_D1.5mm
TP16: GPIO38; TestPoint_Pad_D1.5mm
TP17: GPIO39; TestPoint_Pad_D1.5mm
U11: microSD; TF-SMD_503398-1892; MPN 5033981892; LCSC C428492

Connections:
+1V1: TP6.1 (1_1); also elsewhere on the board
+3V3: C50.1, C51.1, CN1.2, R102.1, R103.1, R104.1, R105.1, R106.1, R107.1, R109.1, R111.1, R112.1, TP2.1 (1_1), U11.4 (VDD); also elsewhere on the board
+3V3_AUX: TP7.1 (1_1); also elsewhere on the board
+5V: D41.2 (A), TP1.1 (1_1); also elsewhere on the board
+5V_SW: TP8.1 (1_1); also elsewhere on the board
/Board support/SD_DAT1: R106.2, U11.8 (DAT1)
/Board support/SD_DAT2: R102.2, U11.1 (DAT2)
/Board support/WS_VDD: C52.1, D41.1 (K), D42.1 (VDD)
GND: C50.2, C51.2, C52.2, CN1.1, CN1.5, CN1.6, D42.3 (VSS), D43.1 (K), D44.1 (K), TP4.1 (1_1), TP5.1 (1_1), U11.6 (VSS), U11.10, U11.11 (EH); also elsewhere on the board
GPIO12: R105.2, U11.7 (DAT0); also elsewhere on the board
GPIO13: R103.2, U11.2 (CD/DAT3); also elsewhere on the board
GPIO14: U11.5 (CLK); also elsewhere on the board
GPIO15: R104.2, U11.3 (CMD); also elsewhere on the board
GPIO20: CN1.3, R111.2, TP10.1 (1_1); also elsewhere on the board
GPIO21: CN1.4, R112.2, TP11.1 (1_1); also elsewhere on the board
GPIO22: R107.2, U11.9; also elsewhere on the board
GPIO23: D42.4 (DIN), R108.1; also elsewhere on the board
GPIO25: R110.1; also elsewhere on the board
GPIO36: TP14.1 (1_1); also elsewhere on the board
GPIO37: TP15.1 (1_1); also elsewhere on the board
GPIO38: TP16.1 (1_1); also elsewhere on the board
GPIO39: TP17.1 (1_1); also elsewhere on the board
unnamed: D43.2 (A), R109.2
unnamed: D44.2 (A), R110.2
USB_D+: TP12.1 (1_1); also elsewhere on the board
USB_D-: TP13.1 (1_1); also elsewhere on the board
VBUS: TP9.1 (1_1); also elsewhere on the board
V_INPUT: TP3.1 (1_1); also elsewhere on the board

Notes on the sheet:
MECHANICAL: 4 x M3 mounting holes (Pi HAT hole spacing if practical) and 3 fiducials.
I2C0 pull-ups (one set for the whole bus: STUSB4500, two INA226 and the Arduino header): 4.7 kohm to +3V3.
TEST POINTS (1.5 mm pads): rails, ground, I2C, USB, and the spare GPIO36-39 for expansion.
STATUS LEDS: power (always on with +3V3) and user LED on GPIO25 (Pico convention). 470 ohm, about 1 mA.
MICROSD (Molex 5033981892, push-push), SPI mode. 10 kohm pull-ups on CMD, DAT0, CS and the unused DAT1/DAT2 as the SD specification asks. Card detect: the two switch contacts (pins 9, 10) close when a card is inserted, pulling GPIO22 low. Verify pins 9/10 against Molex's drawing (not reachable here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
WS2812B-V5 STATUS LED on GPIO23. The LED needs a logic high of 0.63 x VDD (3.15 V at 5 V), which a 3.3 V GPIO barely reaches. A series Schottky diode drops VDD to about 4.6 V, so the threshold falls to about 2.9 V. 100 ohm in the data line; DOUT is unused.

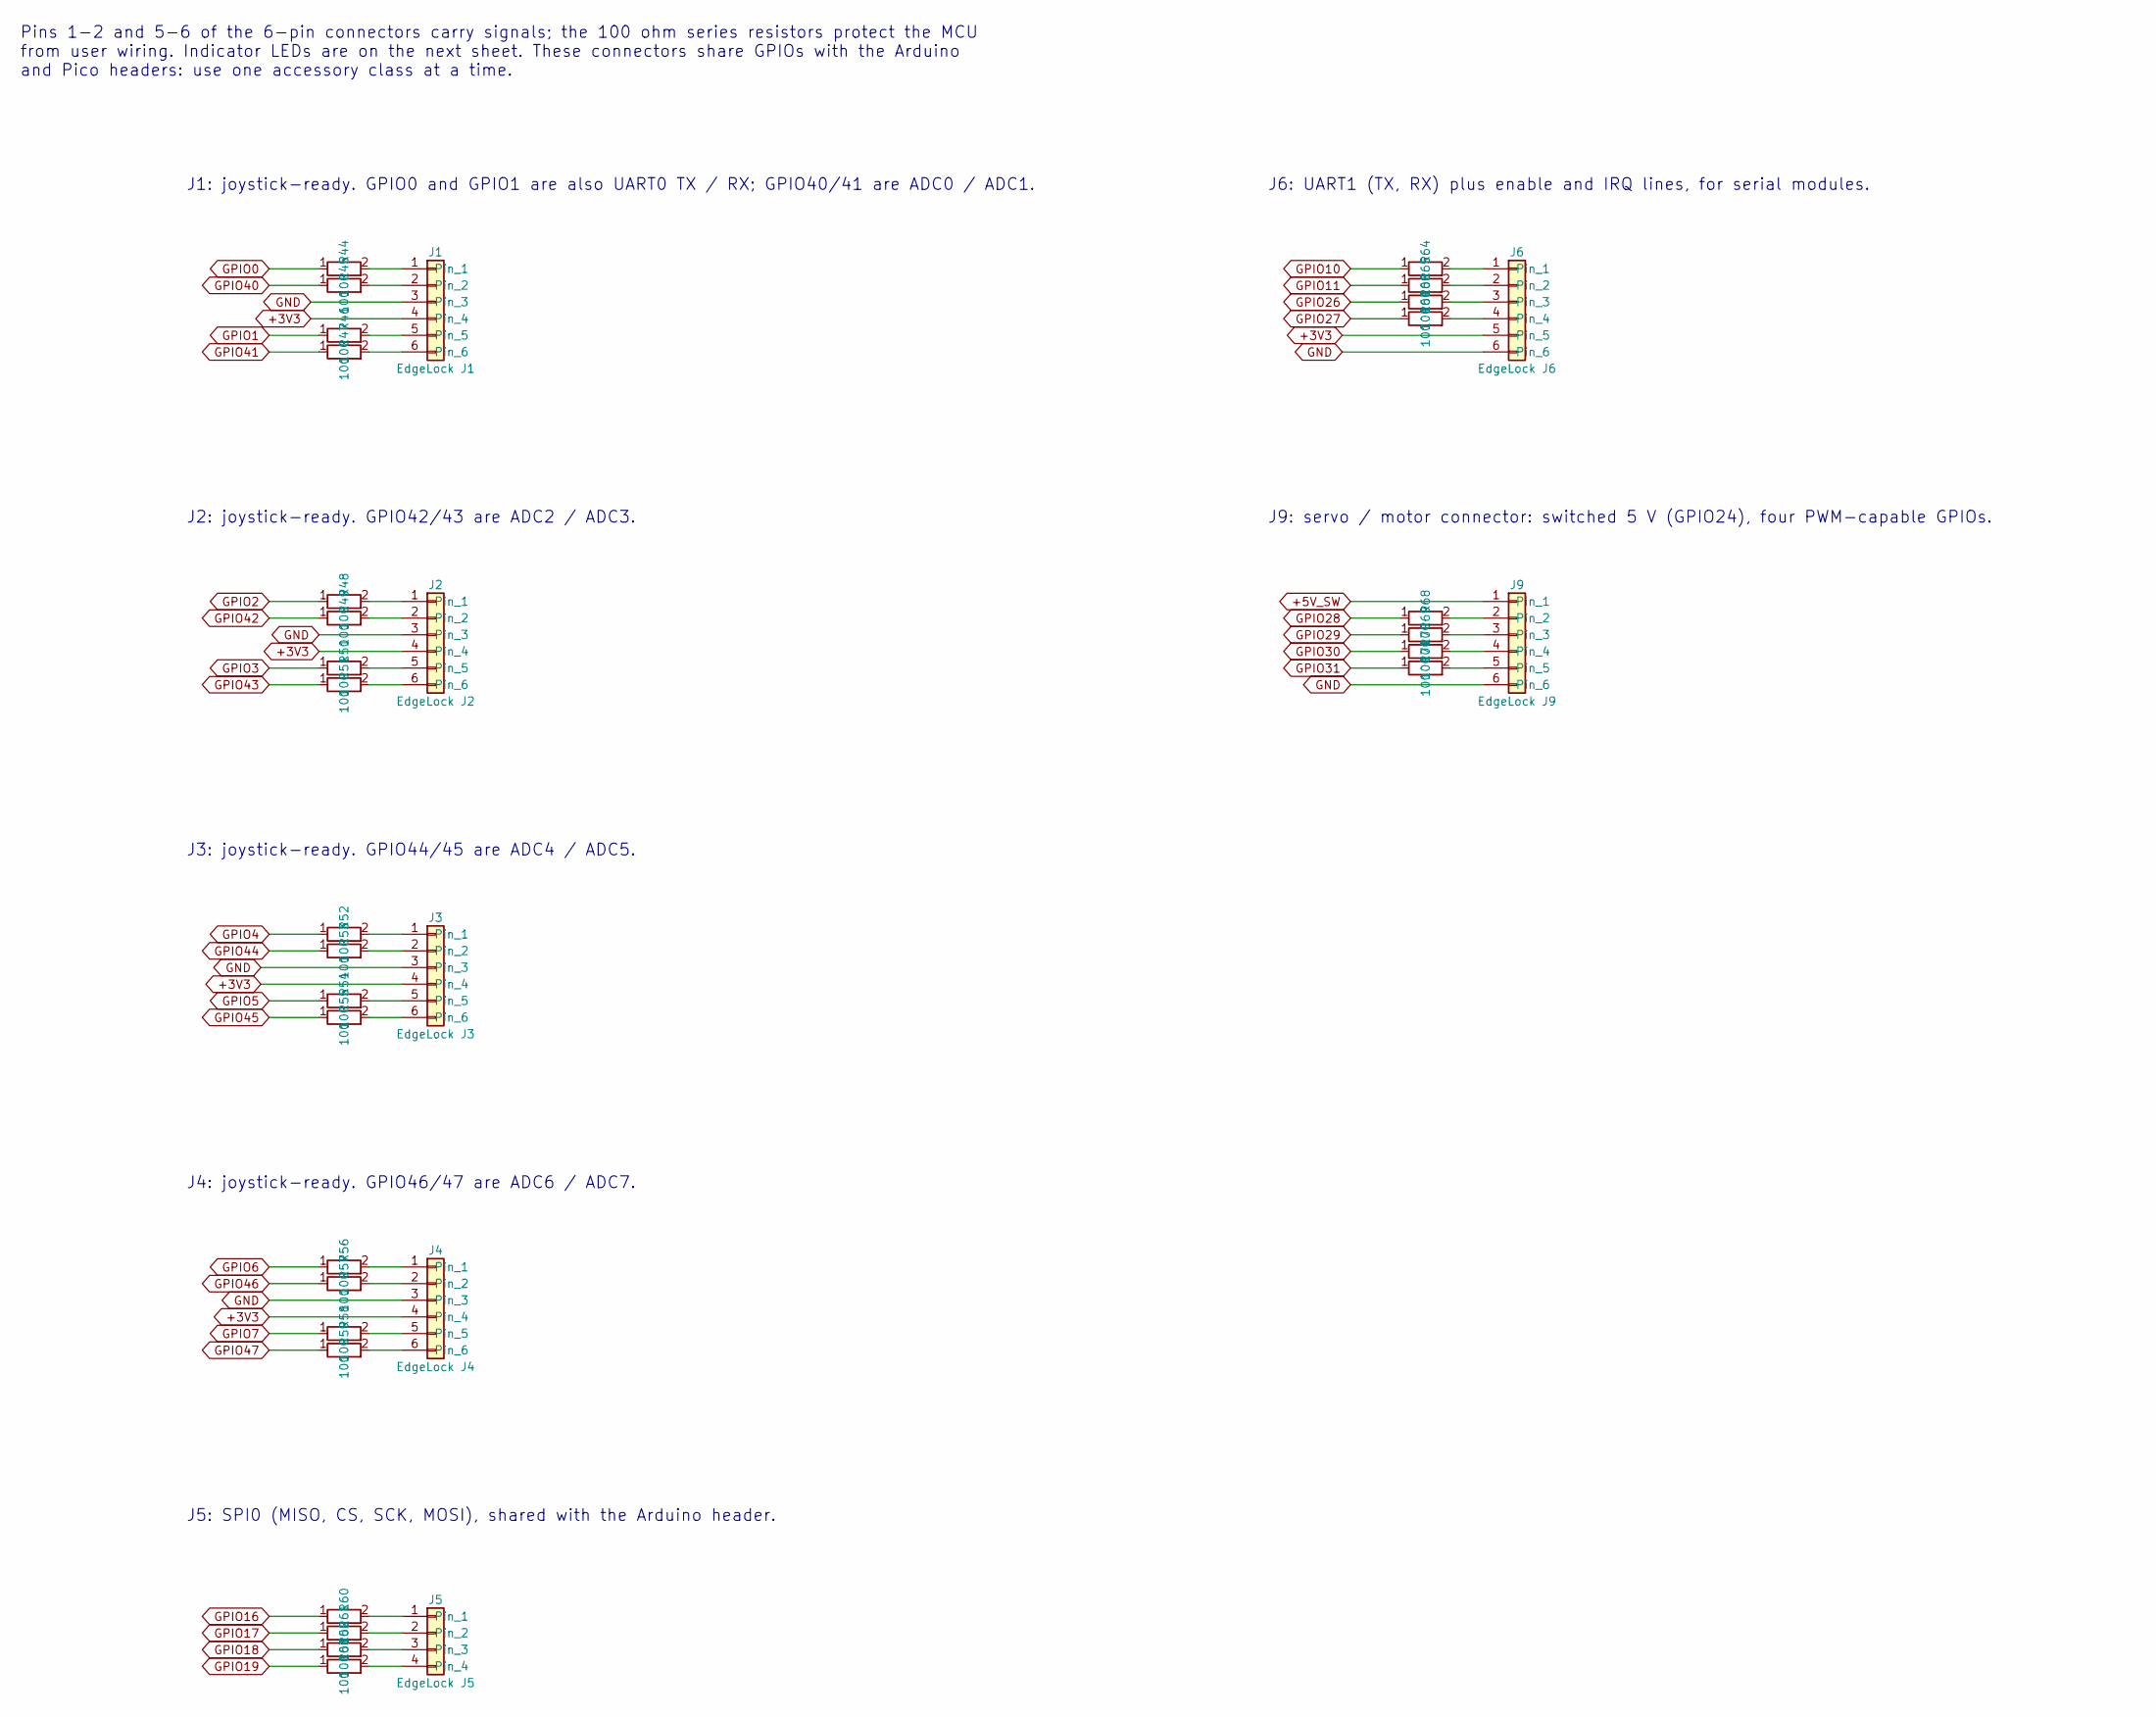
[picture p7: schematic io_edgelock.kicad_sch, EdgeLock connectors]

Parts:
J1: EdgeLock J1; EdgeLock_6ckt_Molex2008900106; MPN Molex 2008900106 (mating housing, bough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
J2: EdgeLock J2; EdgeLock_6ckt_Molex2008900106; MPN Molex 2008900106 (mating housing, bough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
J3: EdgeLock J3; EdgeLock_6ckt_Molex2008900106; MPN Molex 2008900106 (mating housing, bough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
J4: EdgeLock J4; EdgeLock_6ckt_Molex2008900106; MPN Molex 2008900106 (mating housing, bough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
J5: EdgeLock J5; EdgeLock_4ckt_Molex2008900104; MPN Molex 2008900104 (mating housing, bough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
J6: EdgeLock J6; EdgeLock_6ckt_Molex2008900106; MPN Molex 2008900106 (mating housing, bough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
J9: EdgeLock J9; EdgeLock_6ckt_Molex2008900106; MPN Molex 2008900106 (mating housing, bough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
R44, R45, R46, R47, R48, R49, R50, R51, R52, R53, R54, R55, R56, R57, R58, R59, R60, R61, R62, R63, R64, R65, R66, R67, R68, R69, R70, R71: 100; R_0402_1005Metric; MPN 0402WGF1000TCE; LCSC C25076

Connections:
+3V3: J1.4, J2.4, J3.4, J4.4, J6.5; also elsewhere on the board
+5V_SW: J9.1; also elsewhere on the board
GND: J1.3, J2.3, J3.3, J4.3, J6.6, J9.6; also elsewhere on the board
GPIO0: R44.1; also elsewhere on the board
GPIO1: R46.1; also elsewhere on the board
GPIO2: R48.1; also elsewhere on the board
GPIO3: R50.1; also elsewhere on the board
GPIO4: R52.1; also elsewhere on the board
GPIO5: R54.1; also elsewhere on the board
GPIO6: R56.1; also elsewhere on the board
GPIO7: R58.1; also elsewhere on the board
GPIO10: R64.1; also elsewhere on the board
GPIO11: R65.1; also elsewhere on the board
GPIO16: R60.1; also elsewhere on the board
GPIO17: R61.1; also elsewhere on the board
GPIO18: R62.1; also elsewhere on the board
GPIO19: R63.1; also elsewhere on the board
GPIO26: R66.1; also elsewhere on the board
GPIO27: R67.1; also elsewhere on the board
GPIO28: R68.1; also elsewhere on the board
GPIO29: R69.1; also elsewhere on the board
GPIO30: R70.1; also elsewhere on the board
GPIO31: R71.1; also elsewhere on the board
GPIO40: R45.1; also elsewhere on the board
GPIO41: R47.1; also elsewhere on the board
GPIO42: R49.1; also elsewhere on the board
GPIO43: R51.1; also elsewhere on the board
GPIO44: R53.1; also elsewhere on the board
GPIO45: R55.1; also elsewhere on the board
GPIO46: R57.1; also elsewhere on the board
GPIO47: R59.1; also elsewhere on the board
unnamed: J1.1, R44.2
unnamed: J1.2, R45.2
unnamed: J1.5, R46.2
unnamed: J1.6, R47.2
unnamed: J2.1, R48.2
unnamed: J2.2, R49.2
unnamed: J2.5, R50.2
unnamed: J2.6, R51.2
unnamed: J3.1, R52.2
unnamed: J3.2, R53.2
unnamed: J3.5, R54.2
unnamed: J3.6, R55.2
unnamed: J4.1, R56.2
unnamed: J4.2, R57.2
unnamed: J4.5, R58.2
unnamed: J4.6, R59.2
unnamed: J5.1, R60.2
unnamed: J5.2, R61.2
unnamed: J5.3, R62.2
unnamed: J5.4, R63.2
unnamed: J6.1, R64.2
unnamed: J6.2, R65.2
unnamed: J6.3, R66.2
unnamed: J6.4, R67.2
unnamed: J9.2, R68.2
unnamed: J9.3, R69.2
unnamed: J9.4, R70.2
unnamed: J9.5, R71.2

Notes on the sheet:
J3: joystick-ready. GPIO44/45 are ADC4 / ADC5.
J2: joystick-ready. GPIO42/43 are ADC2 / ADC3.
J6: UART1 (TX, RX) plus enable and IRQ lines, for serial modules.
J9: servo / motor connector: switched 5 V (GPIO24), four PWM-capable GPIOs.
J4: joystick-ready. GPIO46/47 are ADC6 / ADC7.
J5: SPI0 (MISO, CS, SCK, MOSI), shared with the Arduino header.
Pins 1-2 and 5-6 of the 6-pin connectors carry signals; the 100 ohm series resistors protect the MCU from user wiring. Indicator LEDs are on the next sheet. These connectors share GPIOs with the Arduino and Pico headers: use one accessory class at a time.
J1: joystick-ready. GPIO0 and GPIO1 are also UART0 TX / RX; GPIO40/41 are ADC0 / ADC1.

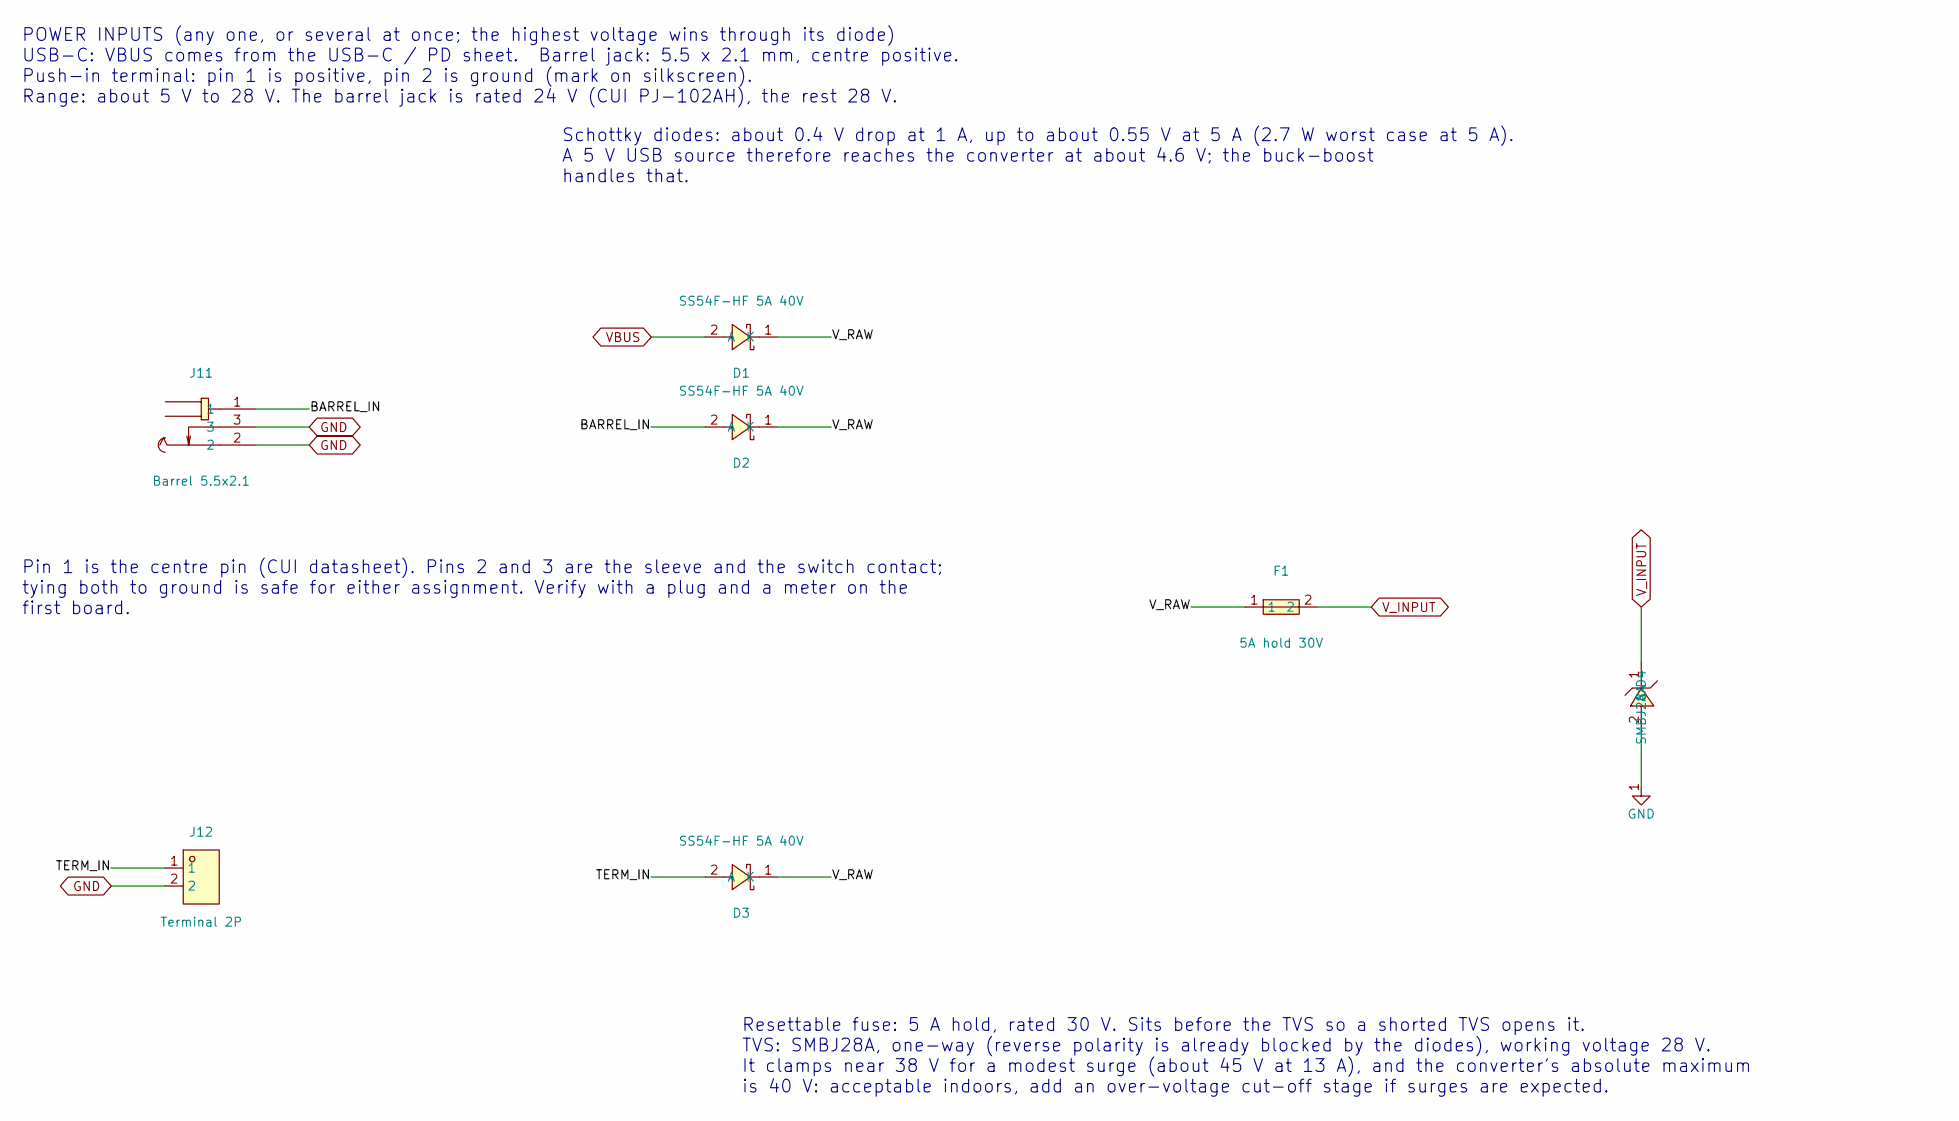
[picture p8: schematic power_input.kicad_sch, Power input]

Parts:
D1, D2, D3: SS54F-HF 5A 40V; DO-214AD_L4.0-W2.5-LS4.8-FD; MPN SS54F-HF; LCSC C5142774
D4: SMBJ28A; SMB_L4.6-W3.6-LS5.3-RD; MPN SMBJ28A; LCSC C178227
F1: 5A hold 30V; F2920; MPN 2920L500/30GR; LCSC C19078763
J11: Barrel 5.5x2.1; DC-IN-TH_PJ-102AH; MPN PJ-102AH; LCSC C3096093
J12: Terminal 2P; CONN-SMD_2060-452; MPN 2060-452/998-404; LCSC C2765055

Connections:
/Power input/BARREL_IN: D2.2 (A), J11.1
/Power input/TERM_IN: D3.2 (A), J12.1
/Power input/V_RAW: D1.1 (K), D2.1 (K), D3.1 (K), F1.1
GND: D4.2 (A), J11.2, J11.3, J12.2; also elsewhere on the board
VBUS: D1.2 (A); also elsewhere on the board
V_INPUT: D4.1 (C), F1.2; also elsewhere on the board

Notes on the sheet:
POWER INPUTS (any one, or several at once; the highest voltage wins through its diode) USB-C: VBUS comes from the USB-C / PD sheet. Barrel jack: 5.5 x 2.1 mm, centre positive. Push-in terminal: pin 1 is positive, pin 2 is ground (mark on silkscreen). Range: about 5 V to 28 V. The barrel jack is rat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
Pin 1 is the centre pin (CUI datasheet). Pins 2 and 3 are the sleeve and the switch contact; tying both to ground is safe for either assignment. Verify with a plug and a meter on the first board.
Schottky diodes: about 0.4 V drop at 1 A, up to about 0.55 V at 5 A (2.7 W worst case at 5 A). A 5 V USB source therefore reaches the converter at about 4.6 V; the buck-boost handles that.
Resettable fuse: 5 A hold, rated 30 V. Sits before the TVS so a shorted TVS opens it. TVS: SMBJ28A, one-way (reverse polarity is already blocked by the diodes), working voltage 28 V. It clamps near 38 V for a modest surge (about 45 V at 13 A), and the converter's absolute maximum is 40 V: acceptabl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

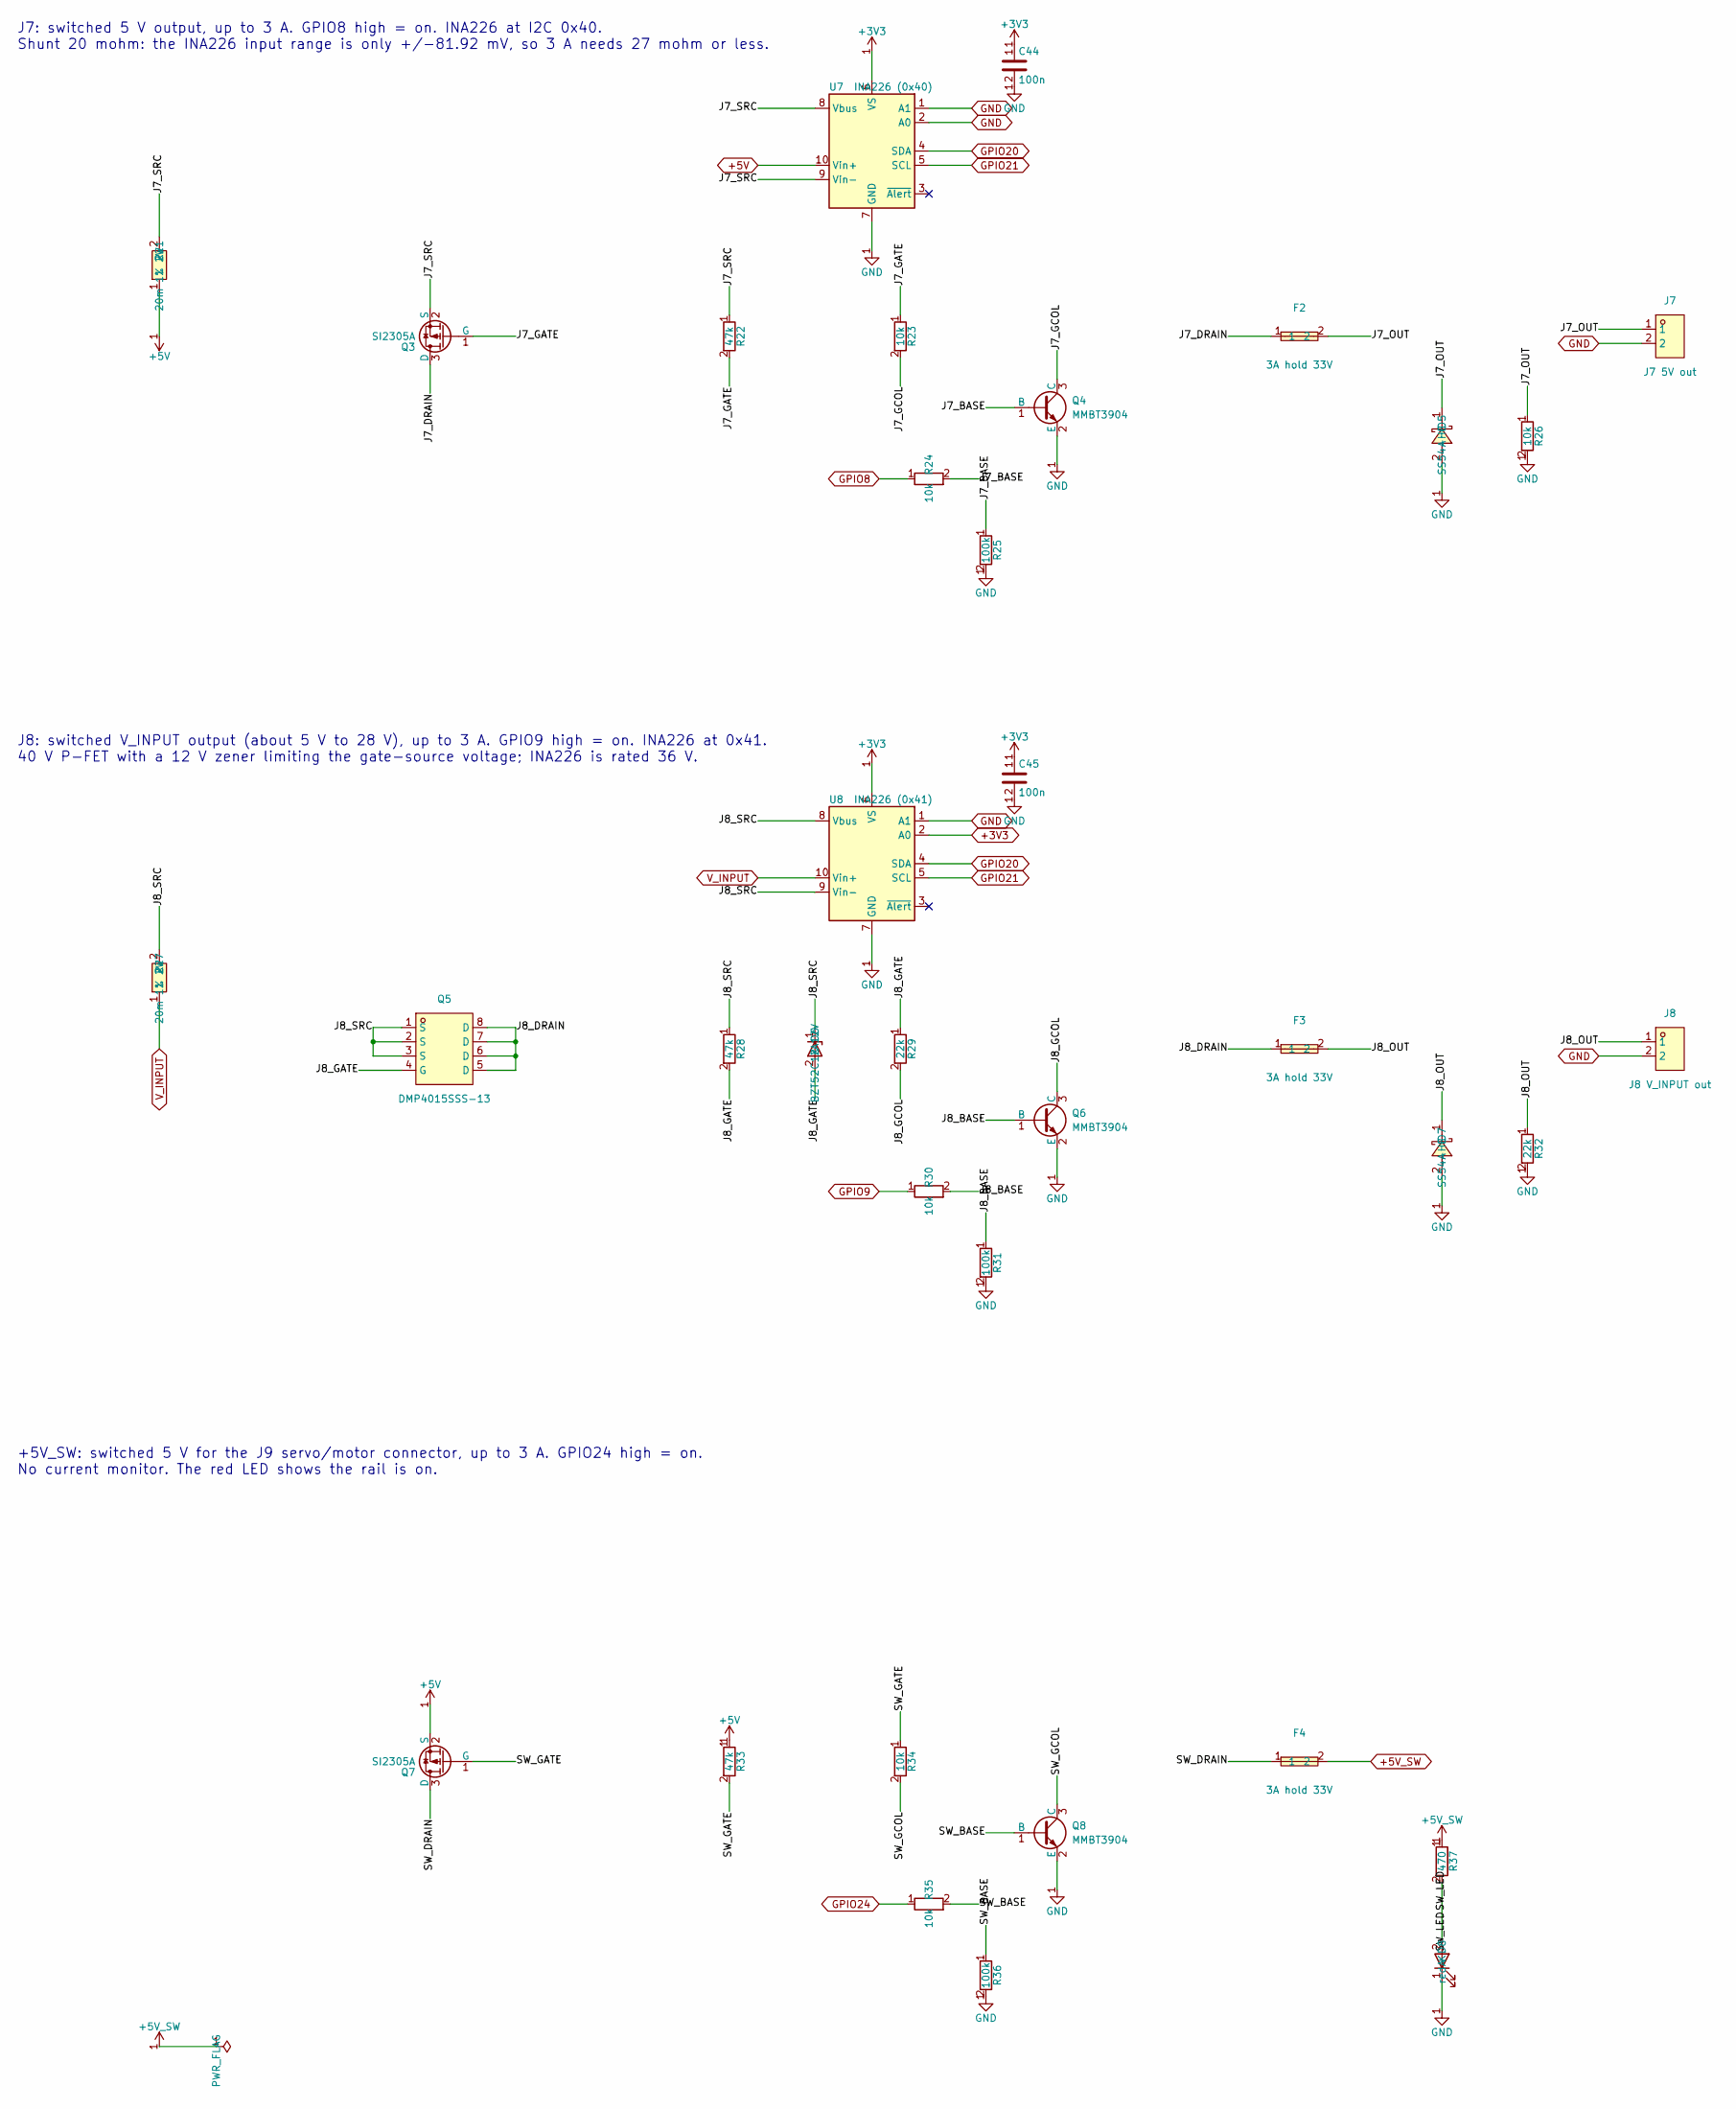
[picture p9: schematic power_outputs.kicad_sch, Switched outputs]

Parts:
C44, C45: 100n; C_0402_1005Metric; MPN CL05B104KB54PNC; LCSC C307331
D5, D7: SS54-HF; SMA_L4.3-W2.5-LS5.0-RD; MPN SS54; LCSC C22452
D6: BZT52C12 12V; D_SOD-123; MPN BZT52C12-13-F; LCSC C177013
D8: red; LED_0603_1608Metric; MPN KT-0603R; LCSC C2286
F2, F3, F4: 3A hold 33V; F1812; MPN 1812L300/33GR; LCSC C54300298
J7: J7 5V out; CONN-TH_P5.00_KF301-5.0-2P; MPN KF301-5.0-2P; LCSC C474881
J8: J8 V_INPUT out; CONN-TH_P5.00_KF301-5.0-2P; MPN KF301-5.0-2P; LCSC C474881
Q3, Q7: SI2305A; SOT-23; MPN SI2305A; LCSC C347488
Q4, Q6, Q8: MMBT3904; SOT-23; MPN MMBT3904LT1G; LCSC C81464
Q5: DMP4015SSS-13; SO-8_L4.9-W3.9-P1.27-LS5.9-BL; MPN DMP4015SSS-13; LCSC C508210
R21, R27: 20m 1% 2W; R2512; MPN GX2512-2W-20mR-1%; LCSC C500720
R22, R28, R33: 47k; R_0402_1005Metric; MPN 0402WGF4702TCE; LCSC C25792
R23, R24, R26, R30, R34, R35: 10k; R_0402_1005Metric; MPN 0402WGF1002TCE; LCSC C25744
R25, R31, R36: 100k; R_0402_1005Metric; MPN 0402WGF1003TCE; LCSC C25741
R29: 22k; R_0603_1608Metric; MPN 0603WAF2202T5E; LCSC C31850
R32: 22k; R_0402_1005Metric; MPN 0402WGF2202TCE; LCSC C25768
R37: 470; R_0402_1005Metric; MPN 0402WGF4700TCE; LCSC C25117
U7: INA226 (0x40); MSOP-10_3x3mm_P0.5mm; MPN INA226AIDGSR; LCSC C49851
U8: INA226 (0x41); MSOP-10_3x3mm_P0.5mm; MPN INA226AIDGSR; LCSC C49851

Connections:
+3V3: C44.1, C45.1, U7.6 (VS), U8.2 (A0), U8.6 (VS); also elsewhere on the board
+5V: Q7.2 (S), R21.1, R33.1, U7.10 (Vin+); also elsewhere on the board
+5V_SW: F4.2, R37.1; also elsewhere on the board
/Switched outputs/J7_BASE: Q4.1 (B), R24.2, R25.1
/Switched outputs/J7_DRAIN: F2.1, Q3.3 (D)
/Switched outputs/J7_GATE: Q3.1 (G), R22.2, R23.1
/Switched outputs/J7_GCOL: Q4.3 (C), R23.2
/Switched outputs/J7_OUT: D5.1 (C), F2.2, J7.1, R26.1
/Switched outputs/J7_SRC: Q3.2 (S), R21.2, R22.1, U7.8 (Vbus), U7.9 (Vin-)
/Switched outputs/J8_BASE: Q6.1 (B), R30.2, R31.1
/Switched outputs/J8_DRAIN: F3.1, Q5.5 (D), Q5.6 (D), Q5.7 (D), Q5.8 (D)
/Switched outputs/J8_GATE: D6.2 (A), Q5.4 (G), R28.2, R29.1
/Switched outputs/J8_GCOL: Q6.3 (C), R29.2
/Switched outputs/J8_OUT: D7.1 (C), F3.2, J8.1, R32.1
/Switched outputs/J8_SRC: D6.1 (K), Q5.1 (S), Q5.2 (S), Q5.3 (S), R27.2, R28.1, U8.8 (Vbus), U8.9 (Vin-)
/Switched outputs/SW_BASE: Q8.1 (B), R35.2, R36.1
/Switched outputs/SW_DRAIN: F4.1, Q7.3 (D)
/Switched outputs/SW_GATE: Q7.1 (G), R33.2, R34.1
/Switched outputs/SW_GCOL: Q8.3 (C), R34.2
/Switched outputs/SW_LED: D8.2 (A), R37.2
GND: C44.2, C45.2, D5.2 (A), D7.2 (A), D8.1 (K), J7.2, J8.2, Q4.2 (E), Q6.2 (E), Q8.2 (E), R25.2, R26.2, R31.2, R32.2, R36.2, U7.1 (A1), U7.2 (A0), U7.7 (GND), U8.1 (A1), U8.7 (GND); also elsewhere on the board
GPIO8: R24.1; also elsewhere on the board
GPIO9: R30.1; also elsewhere on the board
GPIO20: U7.4 (SDA), U8.4 (SDA); also elsewhere on the board
GPIO21: U7.5 (SCL), U8.5 (SCL); also elsewhere on the board
GPIO24: R35.1; also elsewhere on the board
V_INPUT: R27.1, U8.10 (Vin+); also elsewhere on the board

Notes on the sheet:
+5V_SW: switched 5 V for the J9 servo/motor connector, up to 3 A. GPIO24 high = on. No current monitor. The red LED shows the rail is on.
J7: switched 5 V output, up to 3 A. GPIO8 high = on. INA226 at I2C 0x40. Shunt 20 mohm: the INA226 input range is only +/-81.92 mV, so 3 A needs 27 mohm or less.
J8: switched V_INPUT output (about 5 V to 28 V), up to 3 A. GPIO9 high = on. INA226 at 0x41. 40 V P-FET with a 12 V zener limiting the gate-source voltage; INA226 is rated 36 V.
