RFisaac/PicoMondo/kicad/picomondo.kicad_pcb

## KiCad design kicad/picomondo.kicad_pcb (continued)

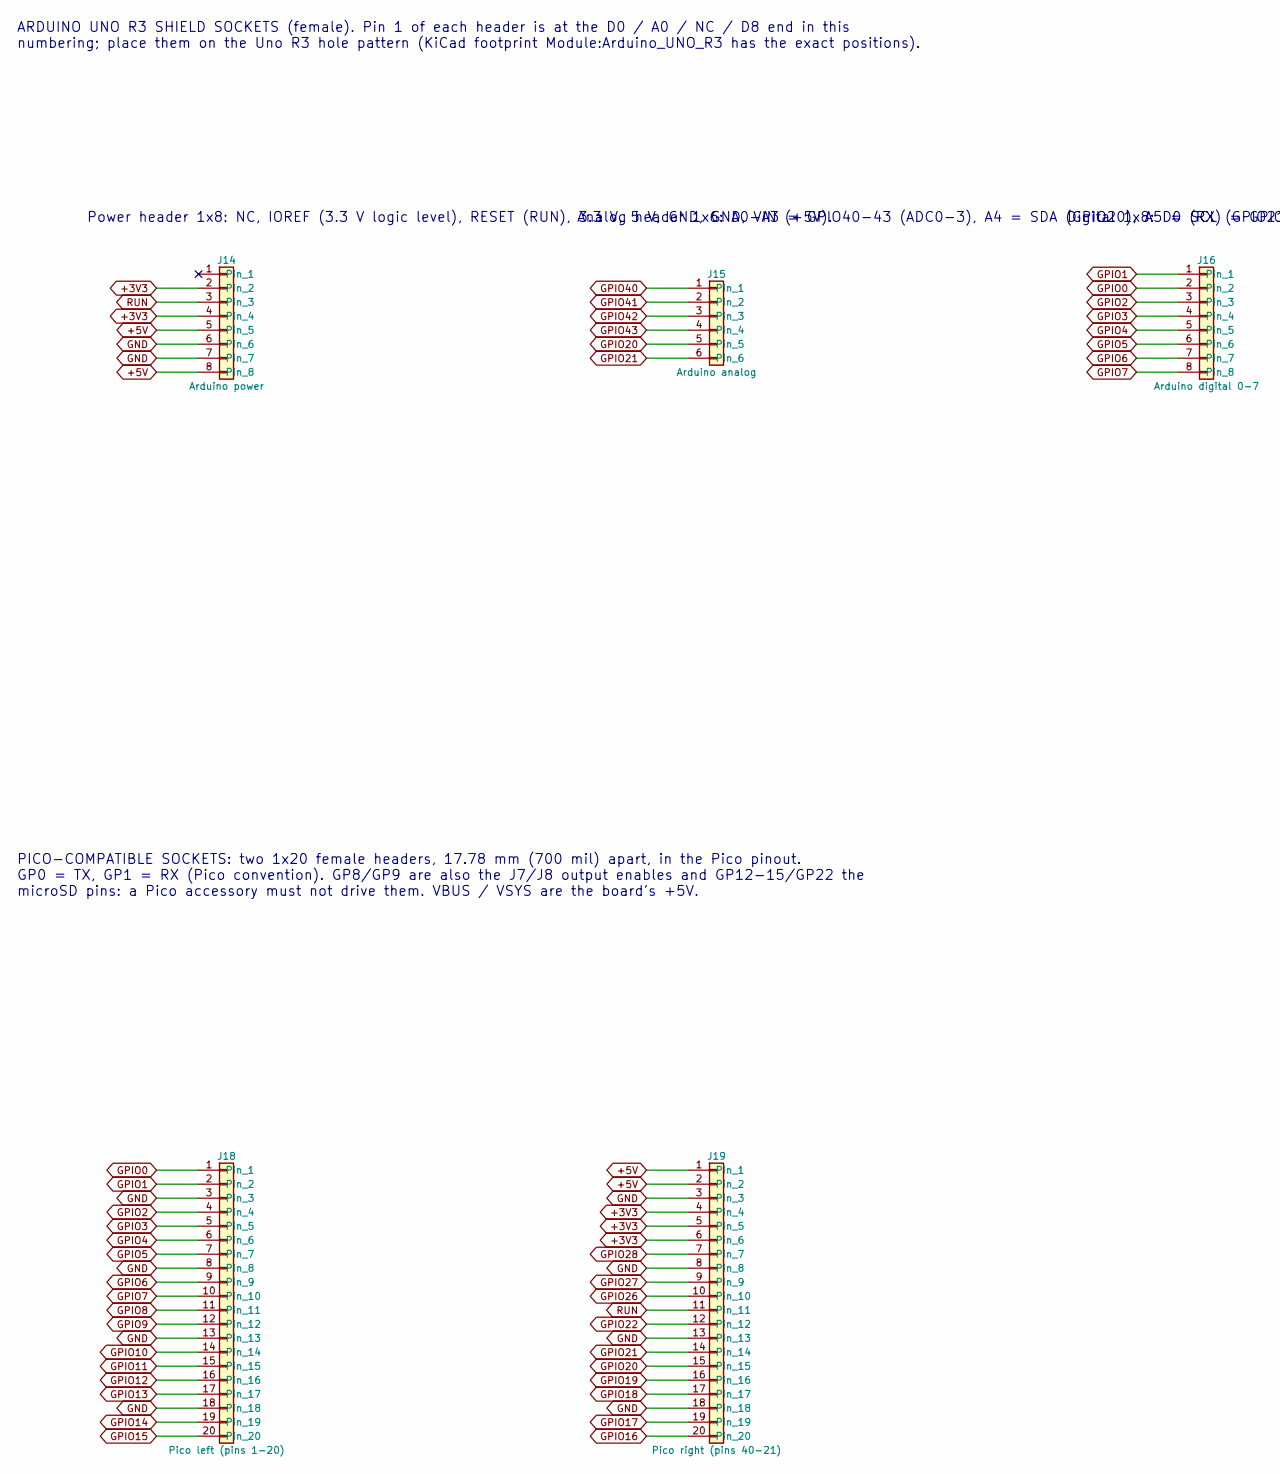
[picture p10: schematic io_headers.kicad_sch, Arduino and Pico headers, part in row 1, column 1]

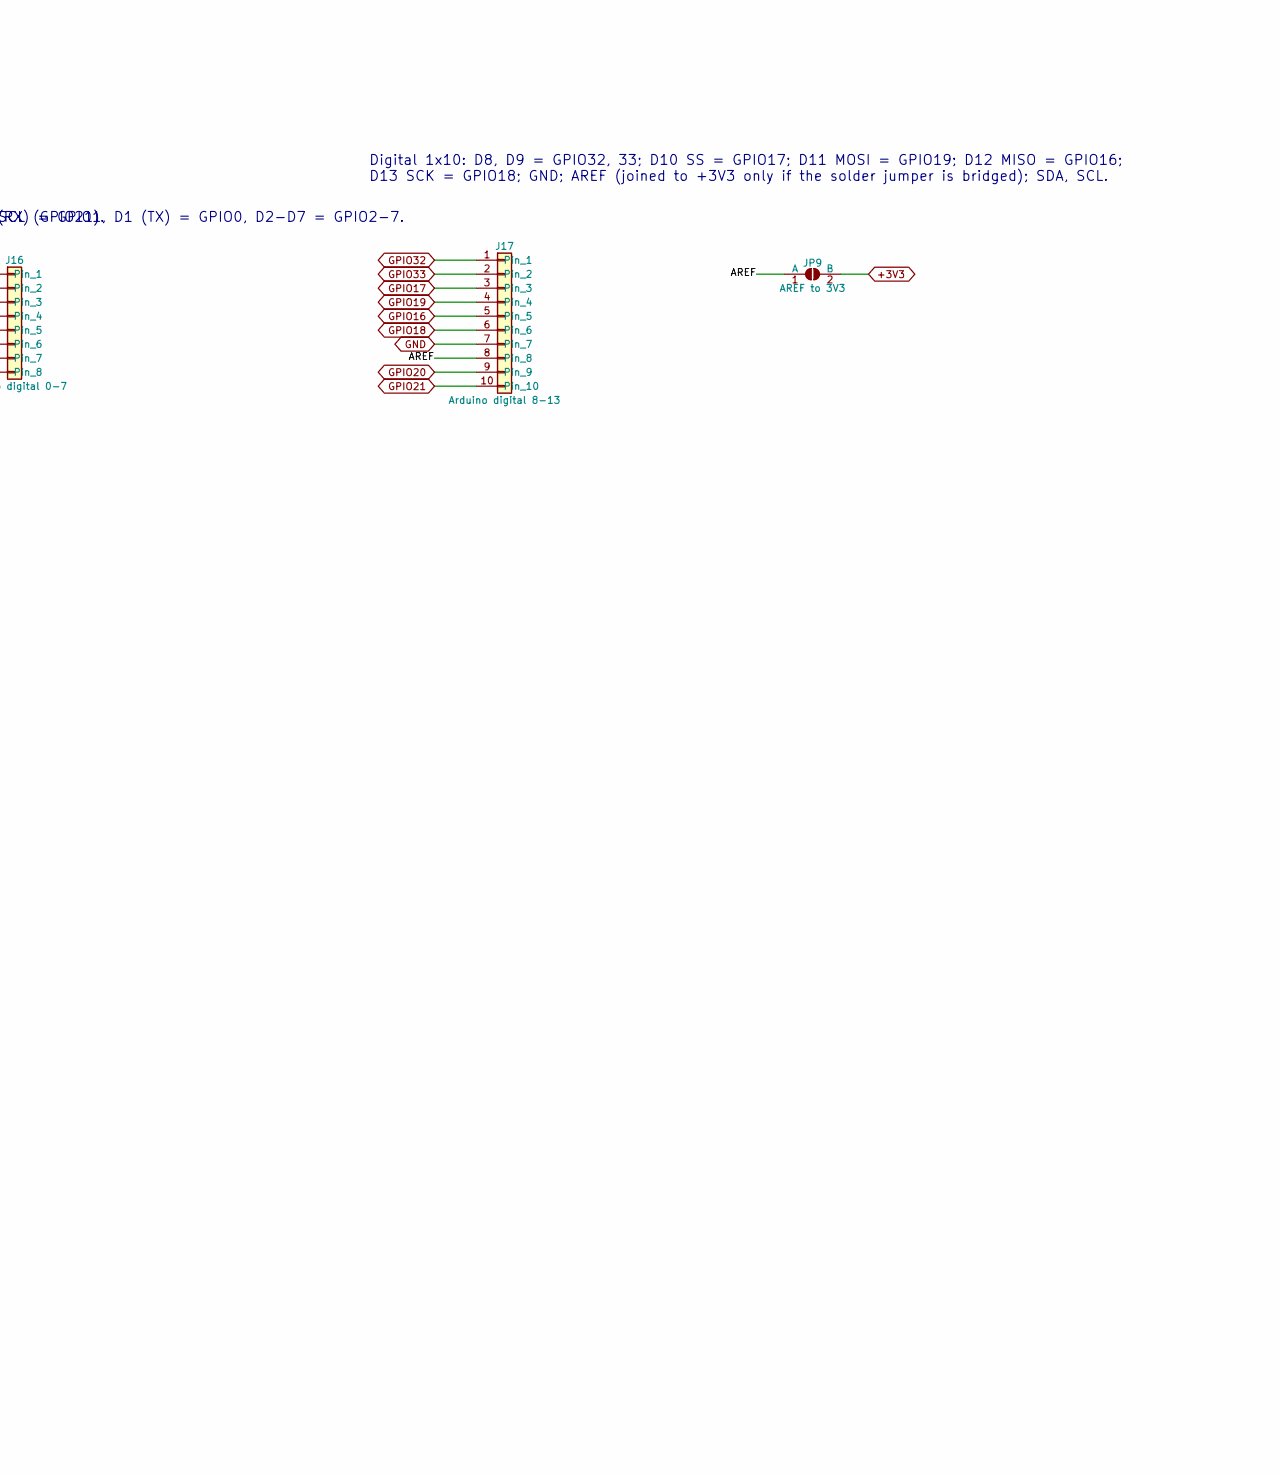
[picture p11: schematic io_headers.kicad_sch, Arduino and Pico headers, part in row 1, column 2]

Parts:
J14: Arduino power; PinSocket_1x08_P2.54mm_Vertical; MPN B-2200S08P-A120; LCSC C124416
J15: Arduino analog; PinSocket_1x06_P2.54mm_Vertical; MPN B-2200S06P-A120; LCSC C124415
J16: Arduino digital 0-7; PinSocket_1x08_P2.54mm_Vertical; MPN B-2200S08P-A120; LCSC C124416
J17: Arduino digital 8-13; PinSocket_1x10_P2.54mm_Vertical; MPN B-2200S10P-B120; LCSC C124423
J18: Pico left (pins 1-20); PinSocket_1x20_P2.54mm_Vertical; MPN B-2200S20P-A120 (1x20 female); LCSC C124410
J19: Pico right (pins 40-21); PinSocket_1x20_P2.54mm_Vertical; MPN B-2200S20P-A120 (1x20 female); LCSC C124410
JP9: AREF to 3V3; SolderJumper-2_P1.3mm_Open_RoundedPad1.0x1.5mm

Connections:
+3V3: J14.2, J14.4, J19.4, J19.5, J19.6, JP9.2 (B); also elsewhere on the board
+5V: J14.5, J14.8, J19.1, J19.2; also elsewhere on the board
/Arduino and Pico headers/AREF: J17.8, JP9.1 (A)
GND: J14.6, J14.7, J17.7, J18.3, J18.8, J18.13, J18.18, J19.3, J19.8, J19.13, J19.18; also elsewhere on the board
GPIO0: J16.2, J18.1; also elsewhere on the board
GPIO1: J16.1, J18.2; also elsewhere on the board
GPIO2: J16.3, J18.4; also elsewhere on the board
GPIO3: J16.4, J18.5; also elsewhere on the board
GPIO4: J16.5, J18.6; also elsewhere on the board
GPIO5: J16.6, J18.7; also elsewhere on the board
GPIO6: J16.7, J18.9; also elsewhere on the board
GPIO7: J16.8, J18.10; also elsewhere on the board
GPIO8: J18.11; also elsewhere on the board
GPIO9: J18.12; also elsewhere on the board
GPIO10: J18.14; also elsewhere on the board
GPIO11: J18.15; also elsewhere on the board
GPIO12: J18.16; also elsewhere on the board
GPIO13: J18.17; also elsewhere on the board
GPIO14: J18.19; also elsewhere on the board
GPIO15: J18.20; also elsewhere on the board
GPIO16: J17.5, J19.20; also elsewhere on the board
GPIO17: J17.3, J19.19; also elsewhere on the board
GPIO18: J17.6, J19.17; also elsewhere on the board
GPIO19: J17.4, J19.16; also elsewhere on the board
GPIO20: J15.5, J17.9, J19.15; also elsewhere on the board
GPIO21: J15.6, J17.10, J19.14; also elsewhere on the board
GPIO22: J19.12; also elsewhere on the board
GPIO26: J19.10; also elsewhere on the board
GPIO27: J19.9; also elsewhere on the board
GPIO28: J19.7; also elsewhere on the board
GPIO32: J17.1; also elsewhere on the board
GPIO33: J17.2; also elsewhere on the board
GPIO40: J15.1; also elsewhere on the board
GPIO41: J15.2; also elsewhere on the board
GPIO42: J15.3; also elsewhere on the board
GPIO43: J15.4; also elsewhere on the board
RUN: J14.3, J19.11; also elsewhere on the board

Notes on the sheet:
Digital 1x10: D8, D9 = GPIO32, 33; D10 SS = GPIO17; D11 MOSI = GPIO19; D12 MISO = GPIO16; D13 SCK = GPIO18; GND; AREF (joined to +3V3 only if the solder jumper is bridged); SDA, SCL.
Power header 1x8: NC, IOREF (3.3 V logic level), RESET (RUN), 3.3 V, 5 V, GND, GND, VIN (+5V).
Digital 1x8: D0 (RX) = GPIO1, D1 (TX) = GPIO0, D2-D7 = GPIO2-7.
Analog header 1x6: A0-A3 = GPIO40-43 (ADC0-3), A4 = SDA (GPIO20), A5 = SCL (GPIO21).
PICO-COMPATIBLE SOCKETS: two 1x20 female headers, 17.78 mm (700 mil) apart, in the Pico pinout. GP0 = TX, GP1 = RX (Pico convention). GP8/GP9 are also the J7/J8 output enables and GP12-15/GP22 the microSD pins: a Pico accessory must not drive them. VBUS / VSYS are the board's +5V.
ARDUINO UNO R3 SHIELD SOCKETS (female). Pin 1 of each header is at the D0 / A0 / NC / D8 end in this numbering; place them on the Uno R3 hole pattern (KiCad footprint Module:Arduino_UNO_R3 has the exact positions).

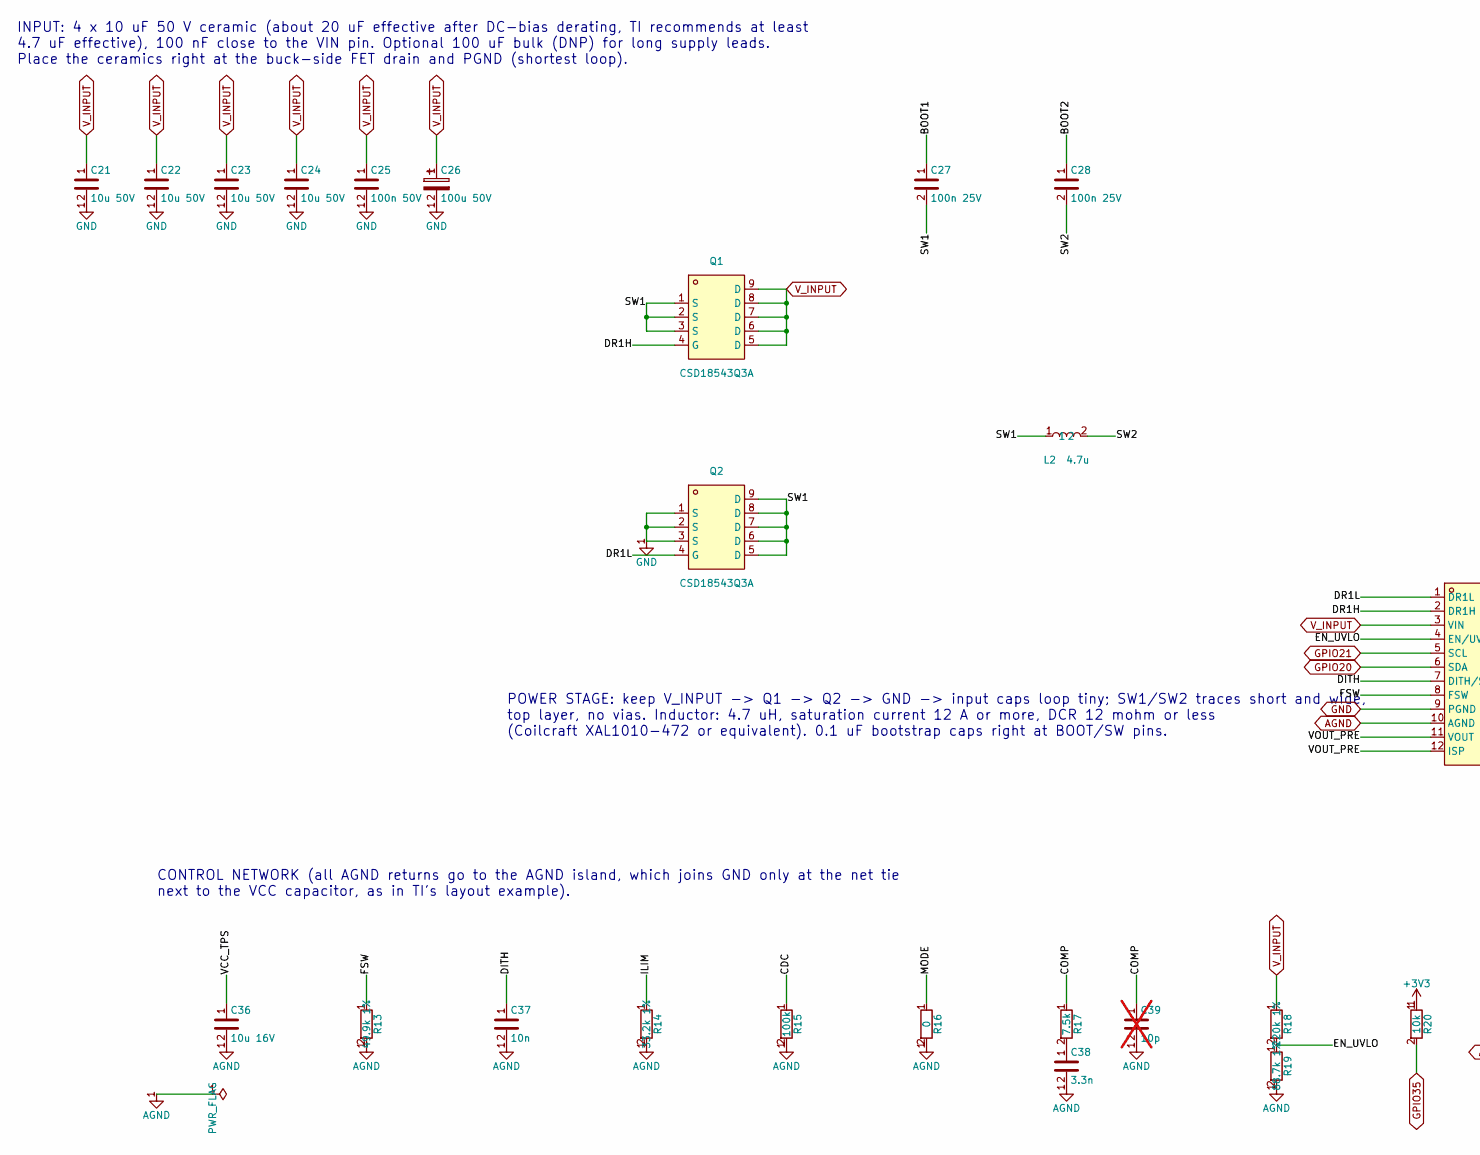
[picture p12: schematic power_buck.kicad_sch, 5V buck-boost, part in row 1, column 1]

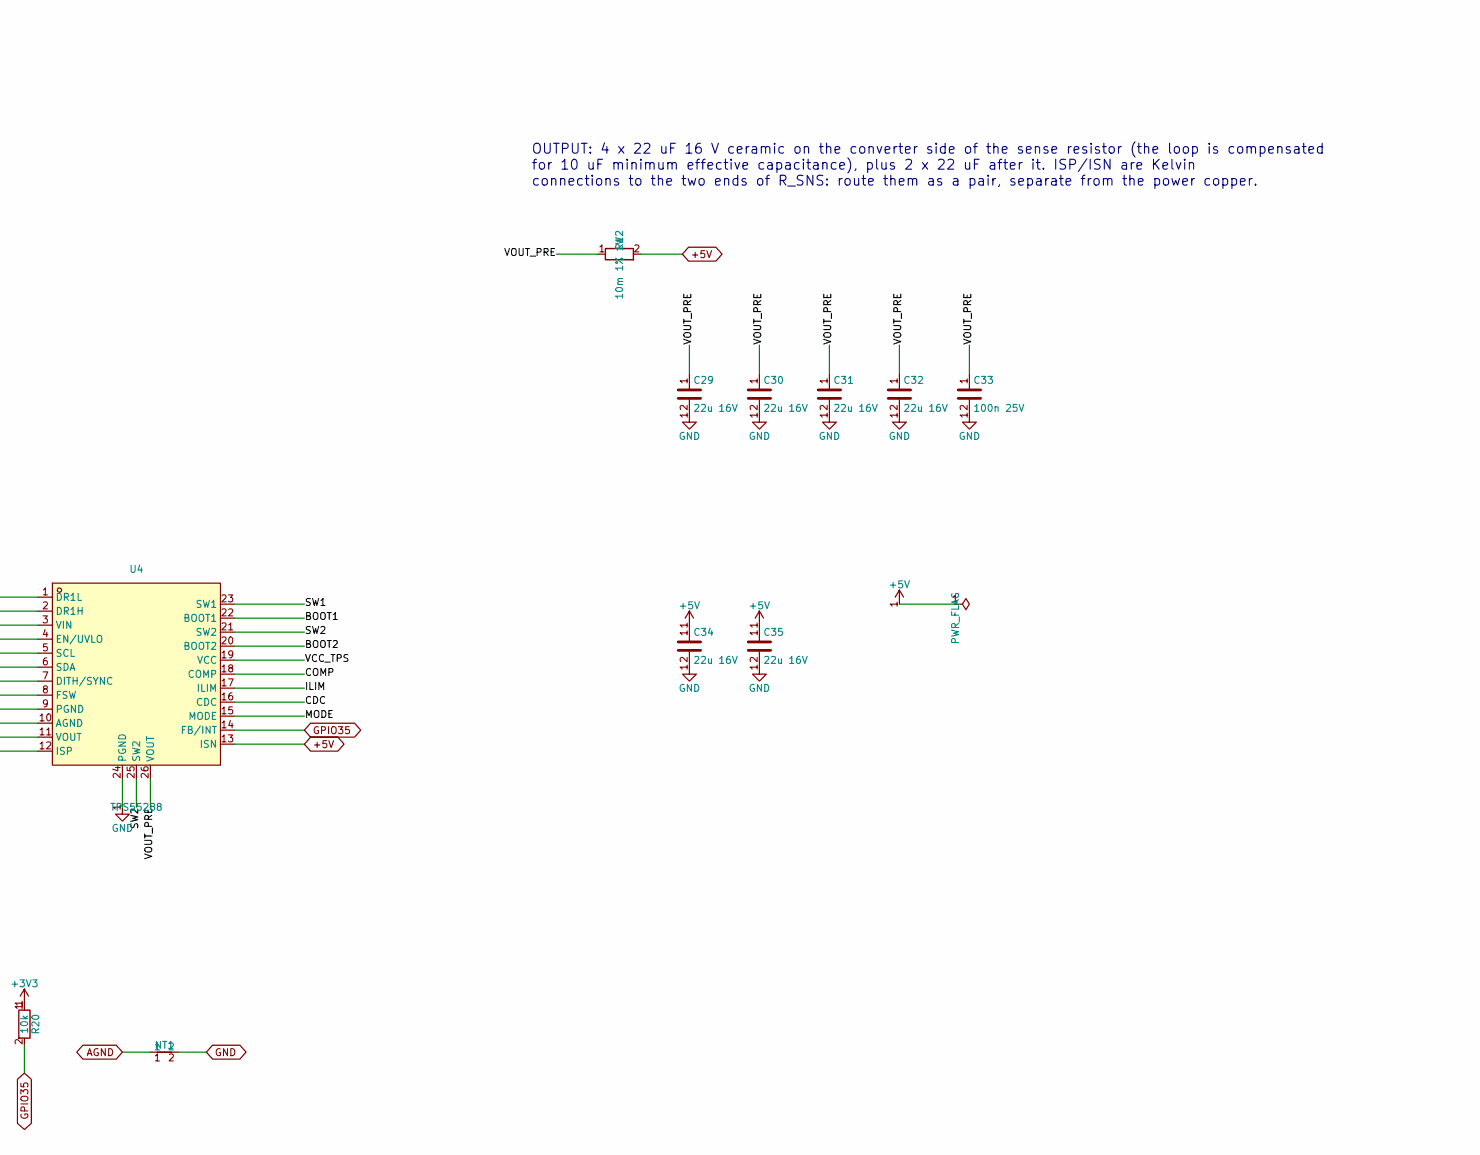
[picture p13: schematic power_buck.kicad_sch, 5V buck-boost, part in row 1, column 2]

Parts:
C21, C22, C23, C24: 10u 50V; C_1206_3216Metric; LCSC C7432782
C25: 100n 50V; C_0402_1005Metric; MPN CL05B104KB54PNC; LCSC C307331
C26: 100u 50V; CP_Elec_8x10
C27, C28, C33: 100n 25V; C_0402_1005Metric; MPN CL05B104KB54PNC; LCSC C307331
C29, C30, C31, C32, C34, C35: 22u 16V; C_1206_3216Metric; LCSC C2985039
C36: 10u 16V; C_0805_2012Metric; MPN CL21A106KAYNNNE; LCSC C15850
C37: 10n; C_0402_1005Metric; MPN CL05B103KB5NNNC; LCSC C15195
C38: 3.3n; C_0402_1005Metric; MPN CL05B332KB5NNNC; LCSC C26404
C39: 10p; C_0402_1005Metric; not fitted
L2: 4.7u; L_Coilcraft_XAL1010-XXX; MPN XAL1010-472MED; LCSC C19271849
NT1: AGND-GND; NetTie-2_SMD_Pad0.5mm
Q1, Q2: CSD18543Q3A; VSONP-8_L3.1-W3.1-P0.65-LS3.5-BL; MPN CSD18543Q3A; LCSC C840100
R12: 10m 1% 1W; R_2512_6332Metric; MPN GX2512-2W-10mR-1%; LCSC C500718
R13: 49.9k 1%; R_0402_1005Metric; MPN 0402WGF4992TCE; LCSC C25897
R14: 33.2k 1%; R_0402_1005Metric; MPN 0402WGF3322TCE; LCSC C122548
R15: 100k; R_0402_1005Metric; MPN 0402WGF1003TCE; LCSC C25741
R16: 0; R_0402_1005Metric; MPN 0402WGF0000TCE; LCSC C17168
R17: 7.5k; R_0402_1005Metric; MPN 0402WGF7501TCE; LCSC C25918
R18: 220k 1%; R_0402_1005Metric; MPN 0402WGF2203TCE; LCSC C25767
R19: 88.7k 1%; R_0402_1005Metric; MPN 0402WGF8872TCE; LCSC C25922
R20: 10k; R_0402_1005Metric; MPN 0402WGF1002TCE; LCSC C25744
U4: TPS55288; VQFN-HR-26_L4.0-W3.5_TPS55288RPMR; MPN TPS55288RPMR; LCSC C2864583

Connections:
+3V3: R20.1; also elsewhere on the board
+5V: C34.1, C35.1, R12.2, U4.13 (ISN); also elsewhere on the board
/5V buck-boost/BOOT1: C27.1, U4.22 (BOOT1)
/5V buck-boost/BOOT2: C28.1, U4.20 (BOOT2)
/5V buck-boost/CDC: R15.1, U4.16 (CDC)
/5V buck-boost/COMP: C39.1, R17.1, U4.18 (COMP)
/5V buck-boost/DITH: C37.1, U4.7 (DITH/SYNC)
/5V buck-boost/DR1H: Q1.4 (G), U4.2 (DR1H)
/5V buck-boost/DR1L: Q2.4 (G), U4.1 (DR1L)
/5V buck-boost/EN_UVLO: R18.2, R19.1, U4.4 (EN/UVLO)
/5V buck-boost/FSW: R13.1, U4.8 (FSW)
/5V buck-boost/ILIM: R14.1, U4.17 (ILIM)
/5V buck-boost/MODE: R16.1, U4.15 (MODE)
/5V buck-boost/SW1: C27.2, L2.1, Q1.1 (S), Q1.2 (S), Q1.3 (S), Q2.5 (D), Q2.6 (D), Q2.7 (D), Q2.8 (D), Q2.9 (D), U4.23 (SW1)
/5V buck-boost/SW2: C28.2, L2.2, U4.21 (SW2), U4.25 (SW2)
/5V buck-boost/VCC_TPS: C36.1, U4.19 (VCC)
/5V buck-boost/VOUT_PRE: C29.1, C30.1, C31.1, C32.1, C33.1, R12.1, U4.11 (VOUT), U4.12 (ISP), U4.26 (VOUT)
AGND: C36.2, C37.2, C38.2, C39.2, NT1.1, R13.2, R14.2, R15.2, R16.2, R19.2, U4.10 (AGND)
GND: C21.2, C22.2, C23.2, C24.2, C25.2, C26.2, C29.2, C30.2, C31.2, C32.2, C33.2, C34.2, C35.2, NT1.2, Q2.1 (S), Q2.2 (S), Q2.3 (S), U4.9 (PGND), U4.24 (PGND); also elsewhere on the board
GPIO20: U4.6 (SDA); also elsewhere on the board
GPIO21: U4.5 (SCL); also elsewhere on the board
GPIO35: R20.2, U4.14 (FB/INT); also elsewhere on the board
unnamed: C38.1, R17.2
V_INPUT: C21.1, C22.1, C23.1, C24.1, C25.1, C26.1, Q1.5 (D), Q1.6 (D), Q1.7 (D), Q1.8 (D), Q1.9 (D), R18.1, U4.3 (VIN); also elsewhere on the board

Notes on the sheet:
OUTPUT: 4 x 22 uF 16 V ceramic on the converter side of the sense resistor (the loop is compensated for 10 uF minimum effective capacitance), plus 2 x 22 uF after it. ISP/ISN are Kelvin connections to the two ends of R_SNS: route them as a pair, separate from the power copper.
INPUT: 4 x 10 uF 50 V ceramic (about 20 uF effective after DC-bias derating, TI recommends at least 4.7 uF effective), 100 nF close to the VIN pin. Optional 100 uF bulk (DNP) for long supply leads. Place the ceramics right at the buck-side FET drain and PGND (shortest loop).
CONTROL NETWORK (all AGND returns go to the AGND island, which joins GND only at the net tie next to the VCC capacitor, as in TI's layout example).
POWER STAGE: keep V_INPUT -> Q1 -> Q2 -> GND -> input caps loop tiny; SW1/SW2 traces short and wide, top layer, no vias. Inductor: 4.7 uH, saturation current 12 A or more, DCR 12 mohm or less (Coilcraft XAL1010-472 or equivalent). 0.1 uF bootstrap caps right at BOOT/SW pins.

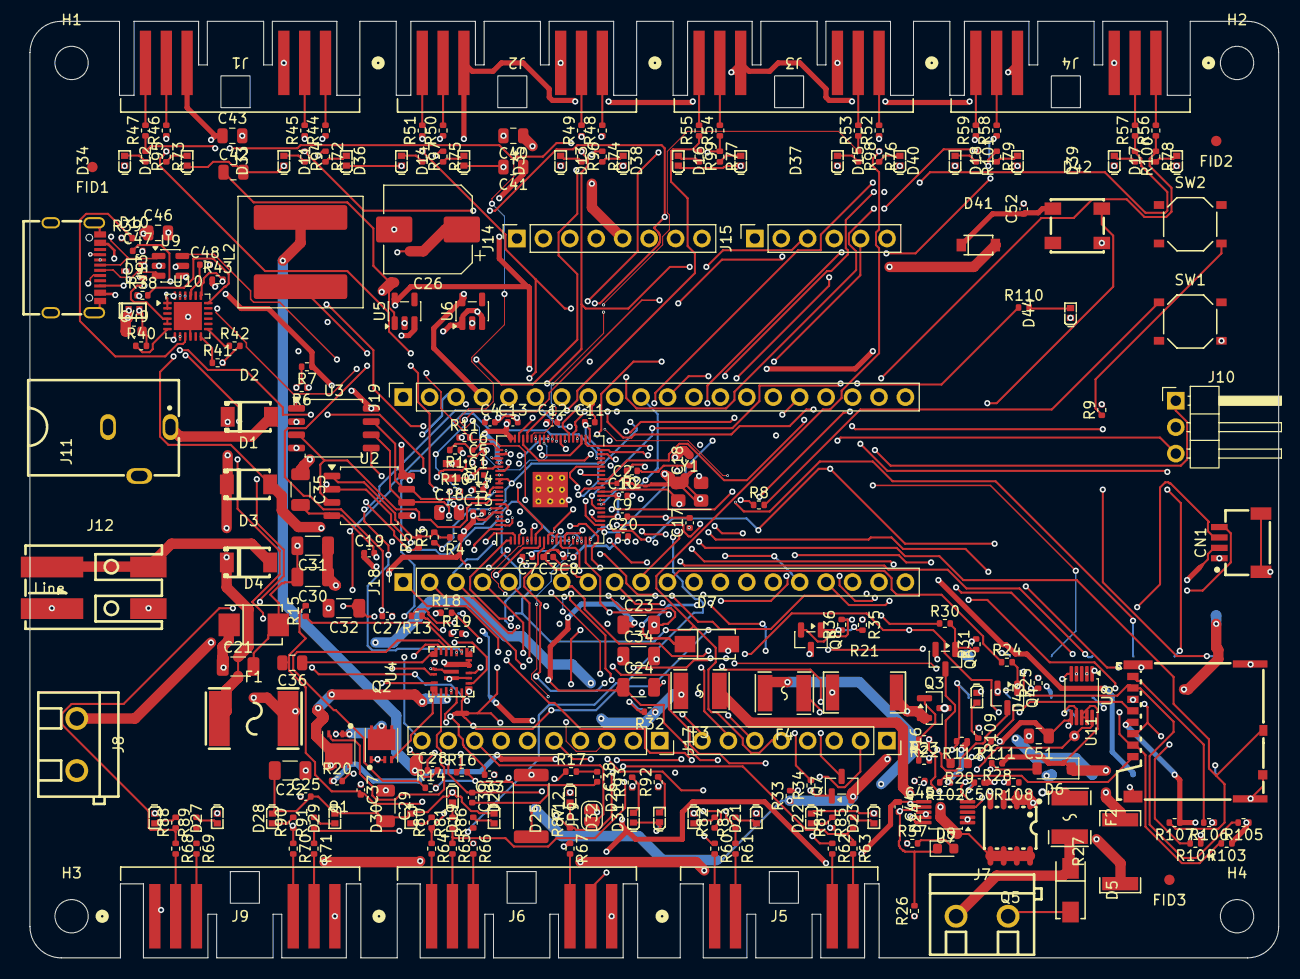
[picture p14: board picomondo.kicad_pcb from above]

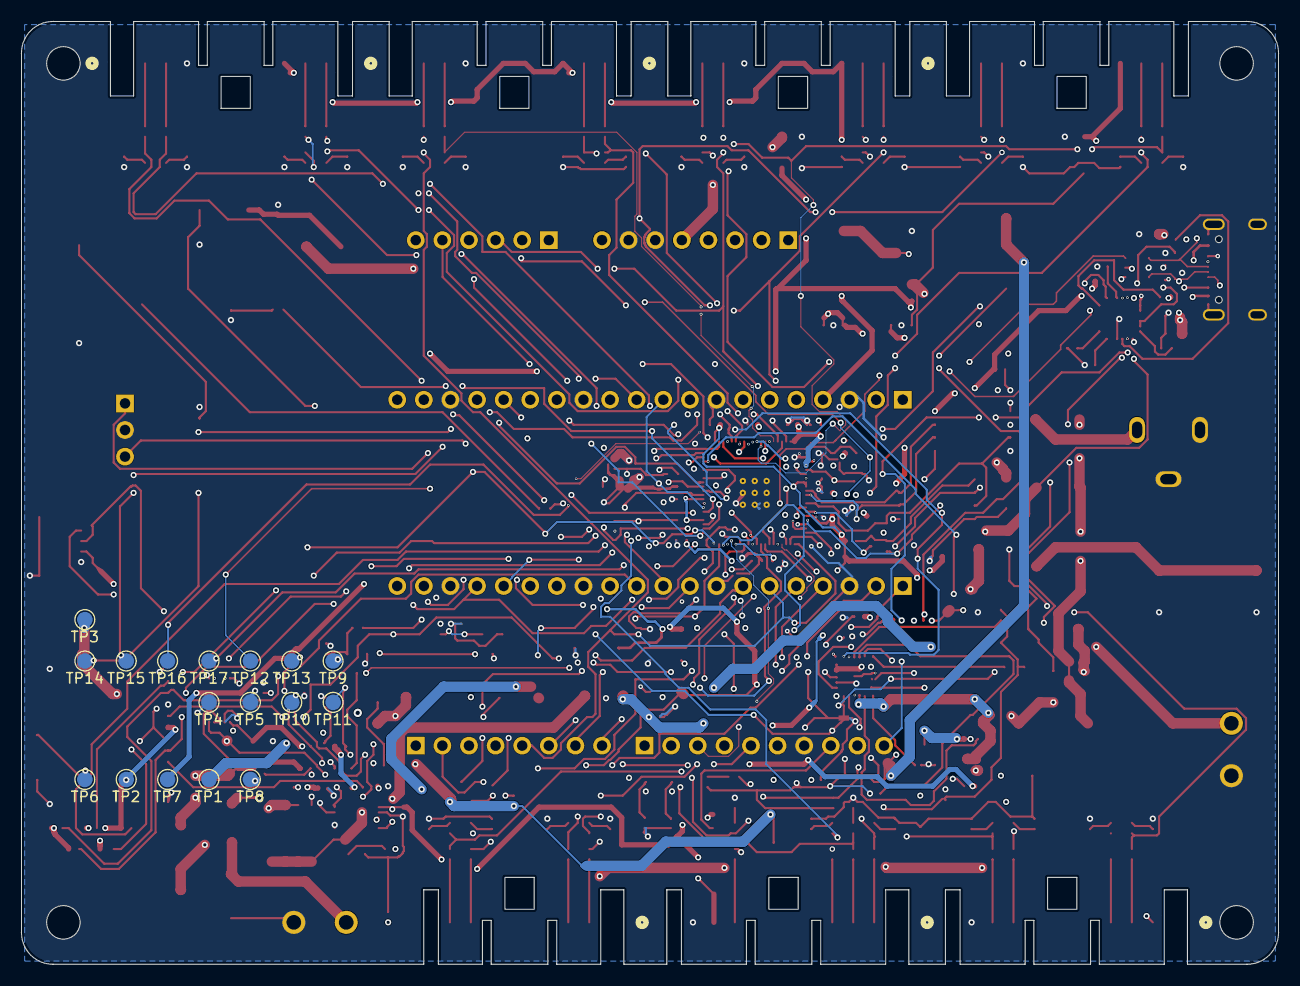
[picture p15: board picomondo.kicad_pcb from below]

Board: 4 copper layers, 120.0 x 90.0 mm, 282 parts (17 on the bottom side), 190 nets.
