RFisaac/PicoMondo/(commit log)

2026-09-30 Configure project
    [project.kicad_pcb, project.kicad_sch]
2026-09-30 Migrate project to atopile 0.15 and add LED indicator test circuit
    ato.yaml moves from the 0.2-era format (ato-version, project.ato entry,
    broken generics dependency) to requires-atopile 0.15.7 with main.ato:App
    as the build entry. main.ato adds a 3.3V -> 330R -> LED test circuit with
    current constraints to exercise the ato skill and toolchain.
    Pinned to 0.15.7 because the Windows wheels for 0.15.8+ crash on CPUs
    without AVX-512 (atopile/atopile#1838).
2026-10-01 Add KiCad 10 design for the RP2350B control board
    Schematic (11 sheets, ERC clean), generated PCB with EdgeLock edge connectors,
    Arduino/Pico sockets plus non-printing shield outlines, design notes, and the
    Python tools that generate and check them. atopile's parts services no longer
    resolve, so the board is designed directly in KiCad.
    [io_edgelock.kicad_sch, io_headers.kicad_sch, io_indicators.kicad_sch, io_misc.kicad_sch, mcu_core.kicad_sch, picomondo.kicad_pcb, picomondo.kicad_sch, power_buck.kicad_sch]
2026-10-01 Ignore KiCad local history
2026-10-05 Remove the atopile exploration
    atopile's parts services are gone and the board is designed in KiCad, so drop the
    atopile project, its skills, CI workflow and template files.
    [project.kicad_pcb, project.kicad_sch, template_40x40.dxf, template_outline.dxf]
2026-10-05 Pick JLCPCB parts for the whole BOM and add BOM/CPL generation
    Adds bom/parts.csv (LCSC numbers and MPNs), scripts to apply it to the schematic and
    board and to generate the JLCPCB BOM, CPL and a live stock report. Swaps the
    BOOTSEL/RESET switch to a basic 5.1 mm part with a matching footprint, and replaces
    out-of-stock parts (SS54, WS2812B, 10u caps, SWD header).
    [io_edgelock.kicad_sch, io_headers.kicad_sch, io_indicators.kicad_sch, io_misc.kicad_sch, mcu_core.kicad_sch, picomondo.kicad_pcb, power_buck.kicad_sch, power_ldo.kicad_sch]
2026-10-06 Rework board layout, swap SWD header to through-hole, add Qwiic port
    - SWD (J10) is now a 1x3 2.54 mm through-hole pin header footprint
    (SWCLK, GND, SWDIO) instead of the JST SH connector; removed from the
    JLCPCB BOM.
    - Add J20 Qwiic connector (XY-SM04B-SRSS-TB) on the I2C bus: GND, +3V3,
    GPIO20 (SDA), GPIO21 (SCL), mounting tabs to GND.
    - Placement/routing progress and the helper scripts used for it.
    DRC still reports open items (unrouted RUN/GPIO24/GPIO29/QSPI_SD0 nets,
    R108/GPIO23 and NT1/GPIO20 shorts, J12 edge clearance, silkscreen
    overlaps); to be fixed in follow-up commits.
    [io_edgelock.kicad_sch, io_headers.kicad_sch, io_indicators.kicad_sch, io_misc.kicad_sch, mcu_core.kicad_sch, picomondo.kicad_pcb, picomondo.kicad_sch, power_buck.kicad_sch]
